flisboac/mixpower-path-nano-bq25620-board/kicad/projects/mixpower-path-nano-bq25620-board-r1/plot/mixpower-path-nano-bq25620-board-r1-output-headers.jpg

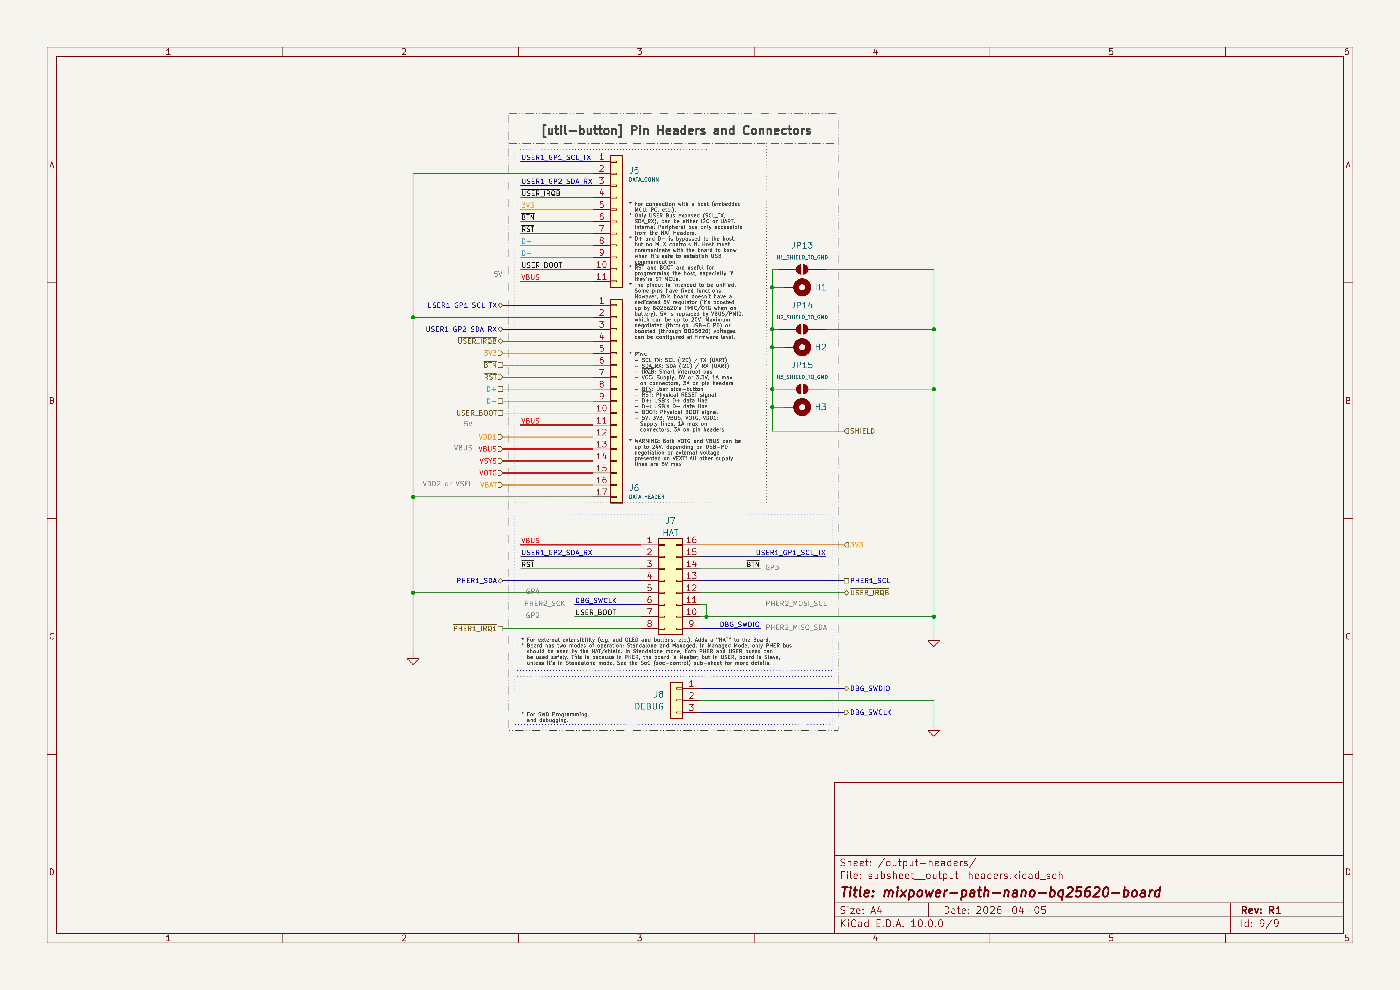
kicad/projects/mixpower-path-nano-bq25620-board-r1/plot/mixpower-path-nano-bq25620-board-r1-output-headers.jpg
