flisboac/mixpower-path-nano-bq25620-board/kicad/projects/mixpower-path-nano-bq25620-board-r1/plot/mixpower-path-nano-bq25620-board-r1.pdf

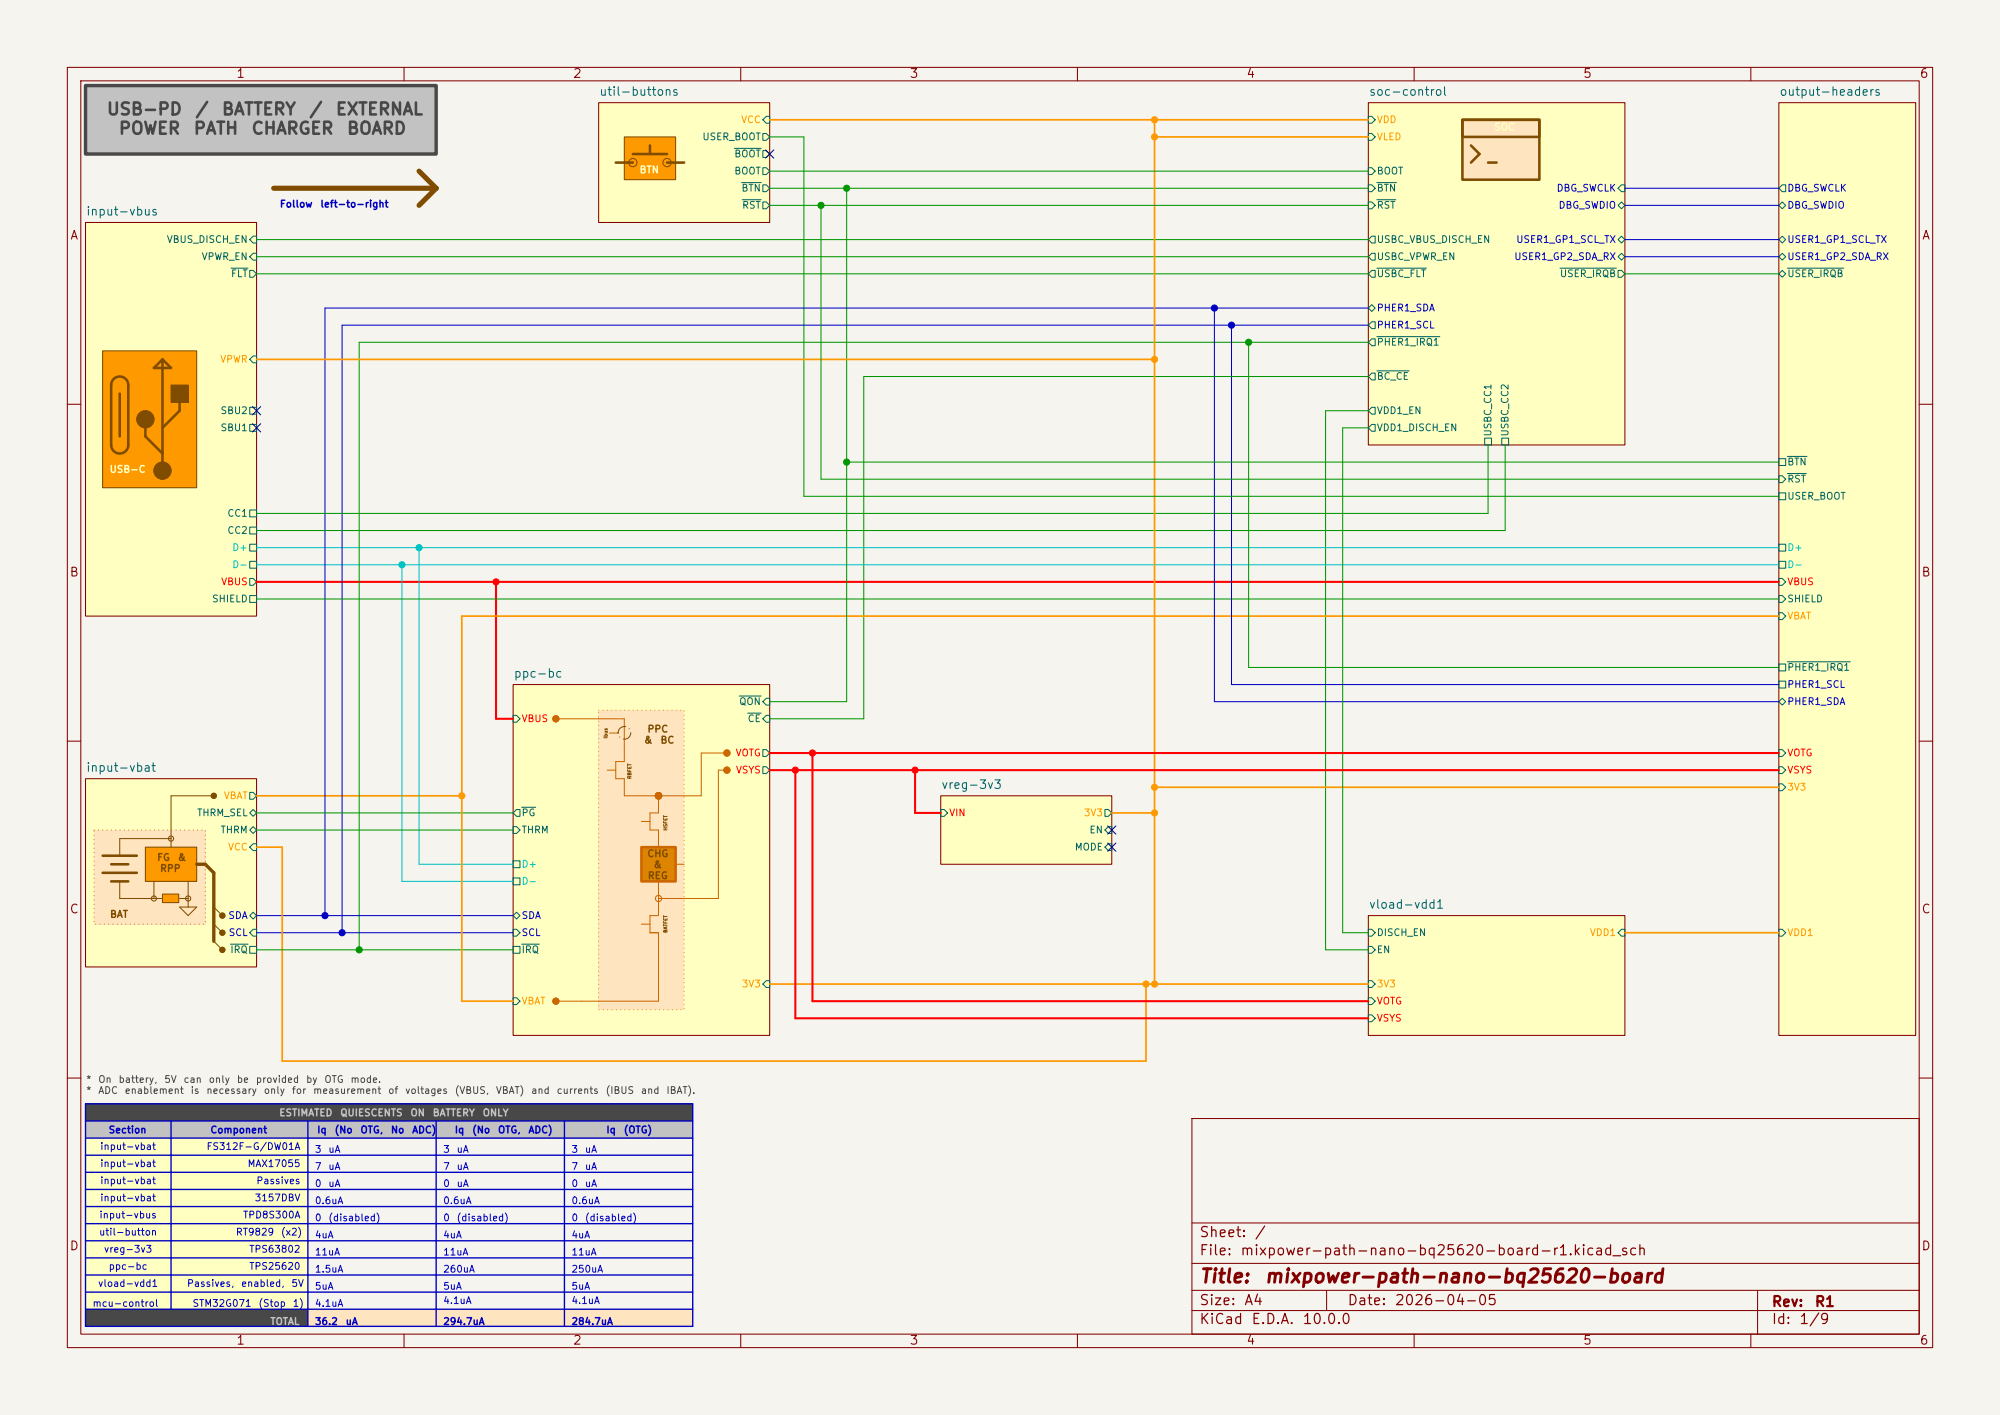
[picture p11: page 1]

* On battery, 5V can only be provided by OTG mode. * ADC enablement is necessary only for measurement of voltages (VBUS, VBAT) and currents (IBUS and IBAT). Ibus USB-PD / BATTERY / EXTERNAL
POWER PATH CHARGER BOARD

Follow left-to-right

input-vbat | FS312F-G/DW01A | 3 uA | 3 uA | 3 uA
input-vbat | MAX17055 | 7 uA | 7 uA | 7 uA
input-vbat | Passives | 0 uA | 0 uA | 0 uA
input-vbat | 3157DBV | 0.6uA | 0.6uA | 0.6uA
input-vbus | RT9829 (x2) TPD8S300A | 0 (disabled) 4uA | 0 (disabled) 4uA | 0 (disabled) util-button 4uA

Sheet: /
D Date: 2026-04-05 KiCad E.D.A. 10.0.0
File: mixpower-path-nano-bq25620-board-r1.kicad_sch
Title: mixpower-path-nano-bq25620-board

vreg-3v3 | TPS63802 TPS25620 | 11uA 1.5uA | 11uA 260uA | 11uA ppc-bc 250uA

vload-vdd1 | Passives, enabled, 5V STM32G071 (Stop 1) | 5uA 4.1uA | 5uA 4.1uA | 5uA mcu-control 4.1uA

Size: A4 | Rev: R1

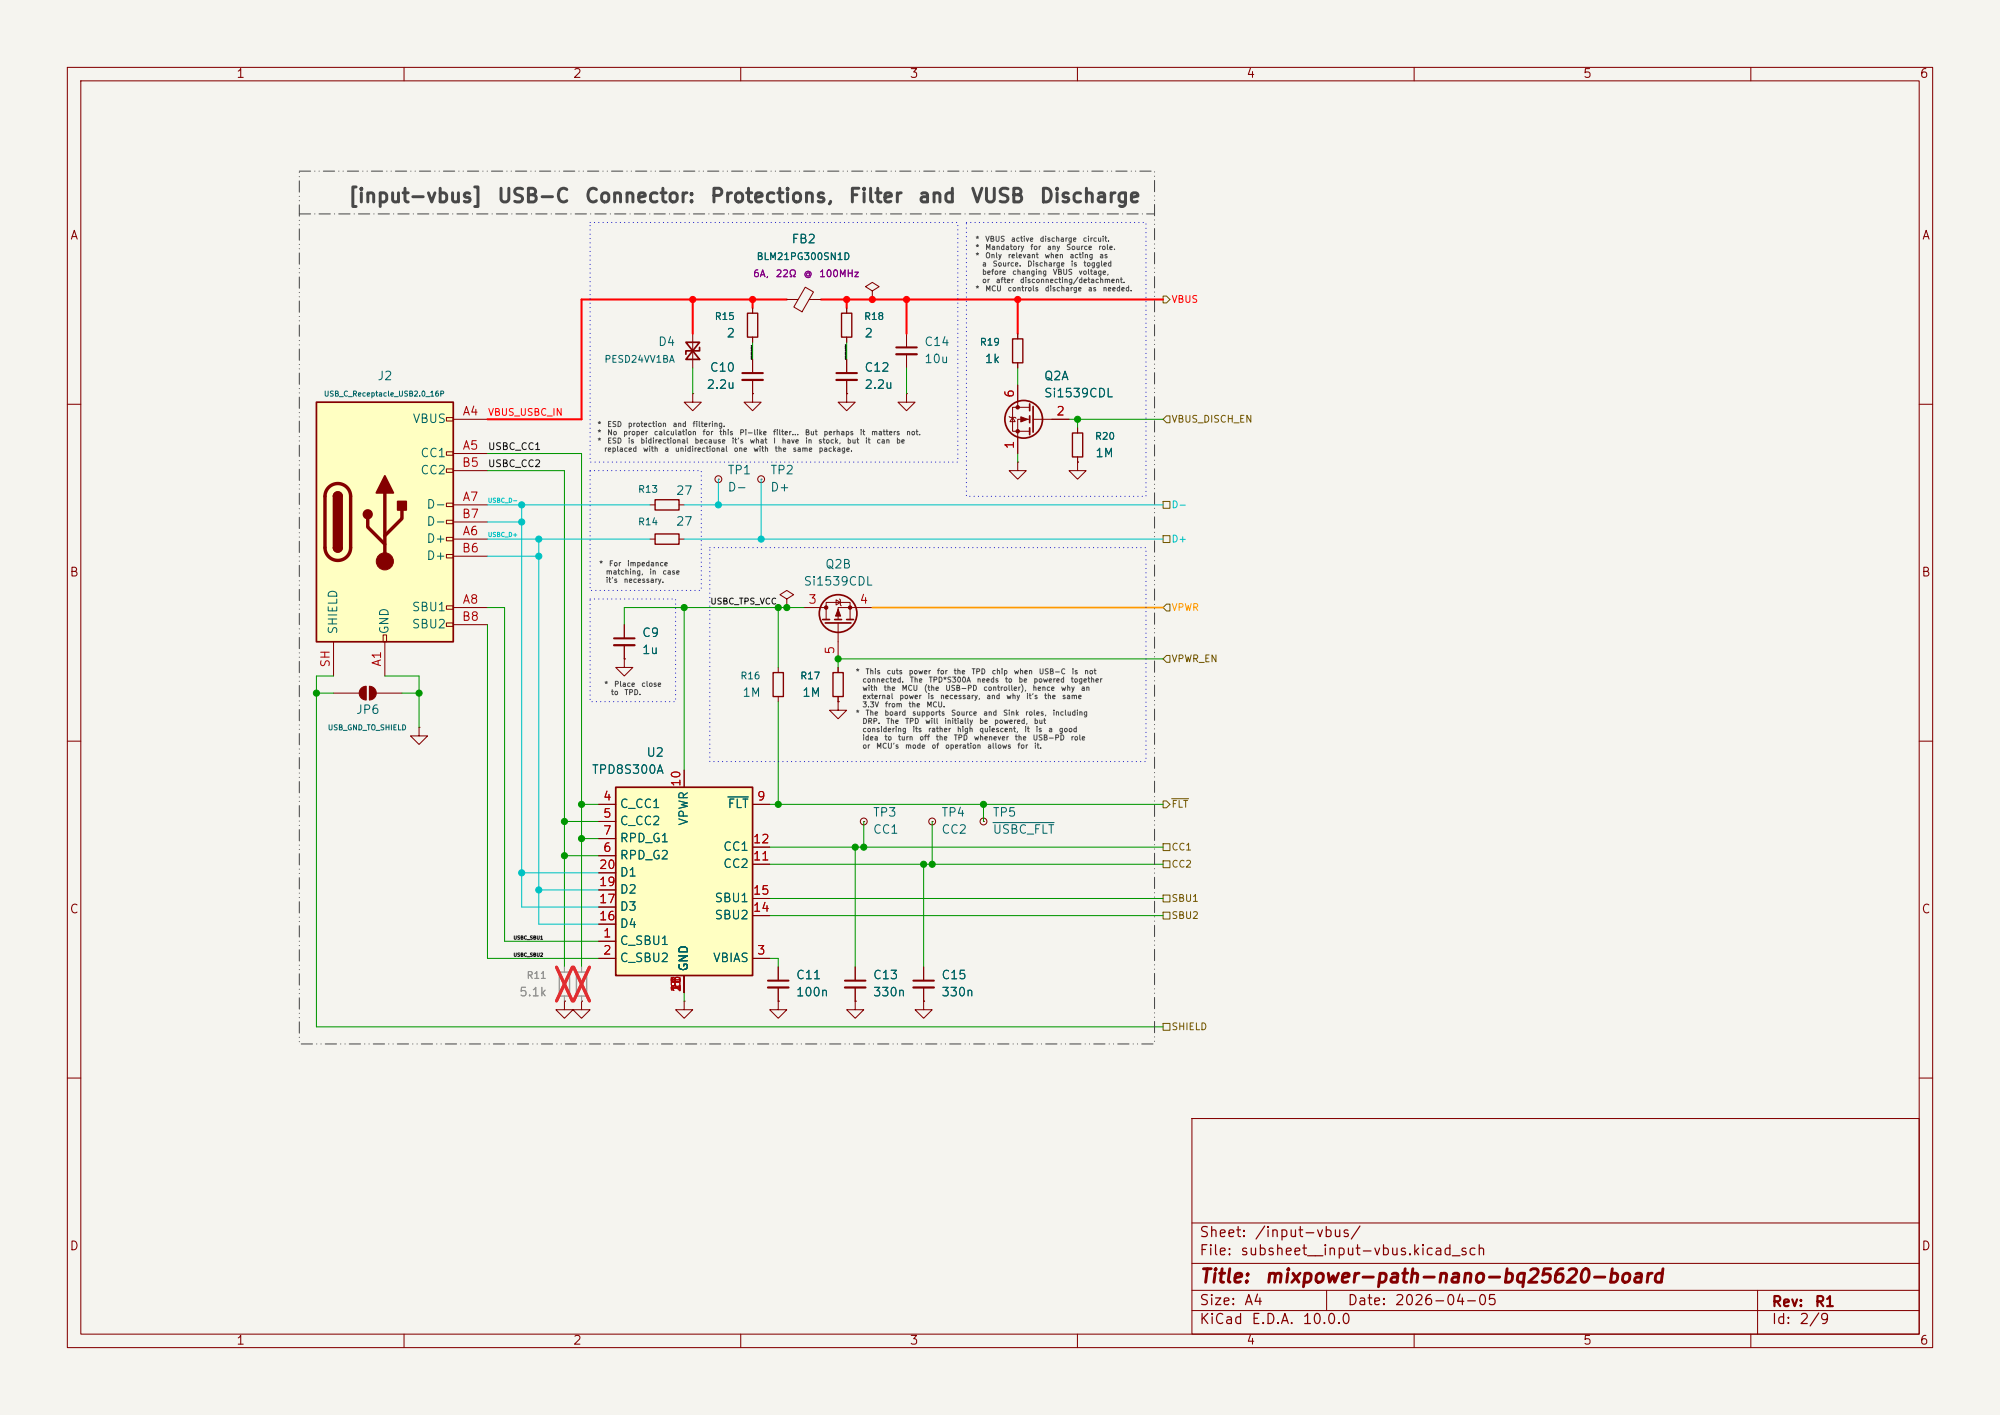
[picture p12: page 2]

before changing VBUS voltage, or after disconnecting/detachment. * MCU controls discharge as needed. [input-vbus] USB-C Connector: Protections, Filter and VUSB Discharge

replaced with a unidirectional one with the same package. FB2

* VBUS active discharge circuit. * Mandatory for any Source role. * Only relevant when acting as a Source. Discharge is toggled

to TPD. * ESD protection and filtering. * No proper calculation for this Pi-like filter... But perhaps it matters not. * ESD is bidirectional because it's what I have in stock, but it can be

external power is necessary, and why it's the same 3.3V from the MCU. * The board supports Source and Sink roles, including DRP. The TPD will initially be powered, but considering its rather high quiescent, it is a good

idea to turn off the TPD whenever the USB-PD role or MCU's mode of operation allows for it.

Sheet: /input-vbus/
D Date: 2026-04-05 KiCad E.D.A. 10.0.0
File: subsheet__input-vbus.kicad_sch
Title: mixpower-path-nano-bq25620-board

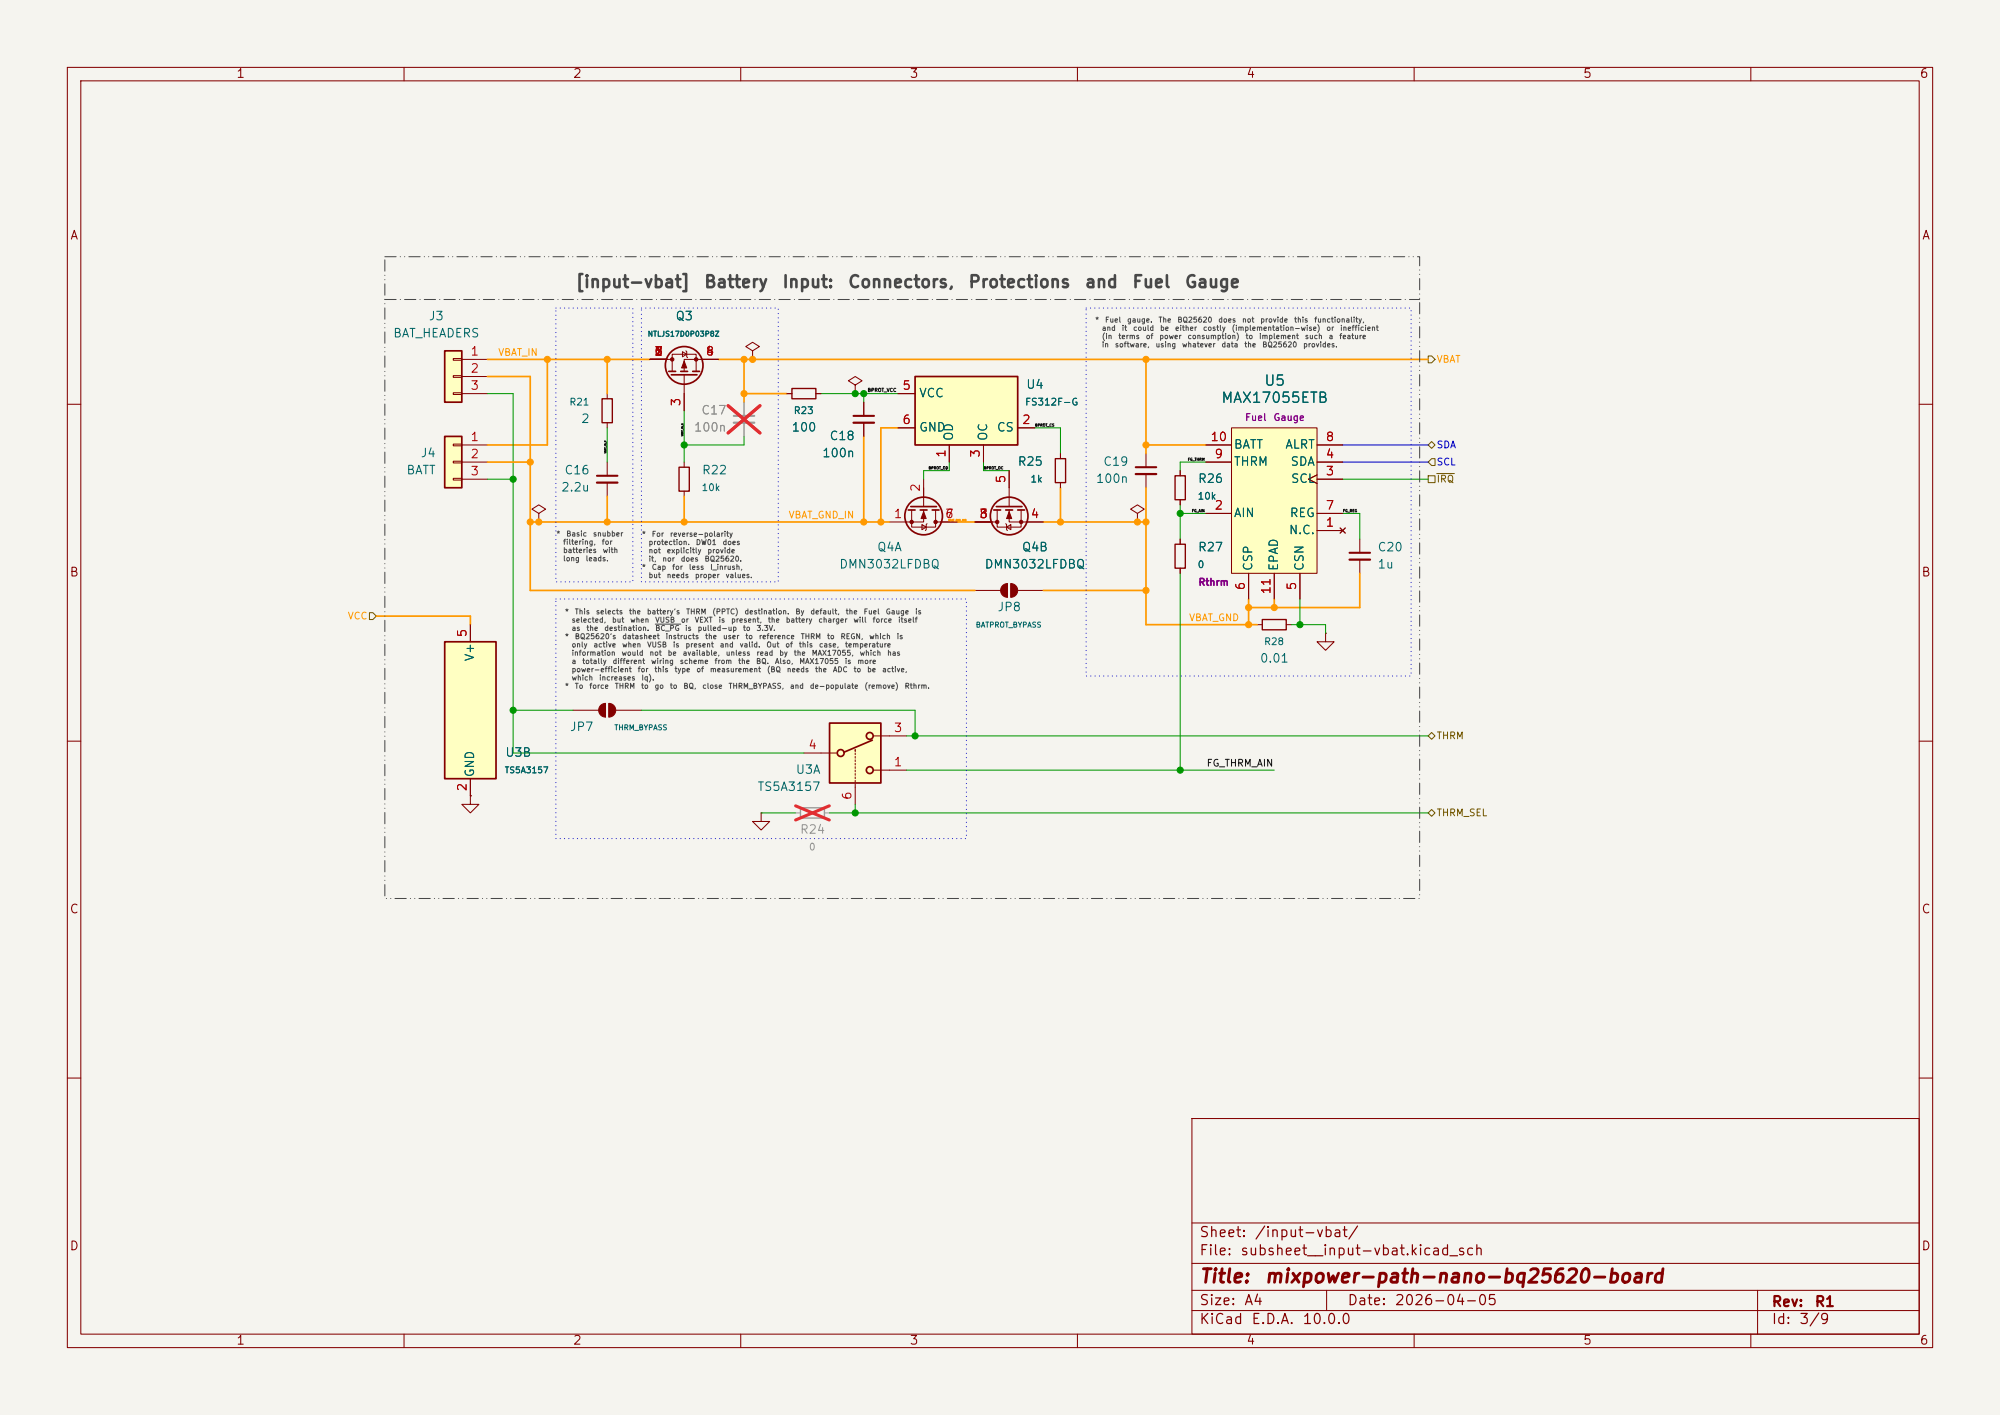
[picture p13: page 3]

in software, using whatever data the BQ25620 provides. U4

information would not be available, unless read by the MAX17055, which has a totally different wiring scheme from the BQ. Also, MAX17055 is more power-efficient for this type of measurement (BQ needs the ADC to be active, which increases Iq). * To force THRM to go to BQ, close THRM_BYPASS, and de-populate (remove) Rthrm. * Basic snubber
filtering, for batteries with

* For reverse-polarity protection. DW01 does not explicitly provide

it, nor does BQ25620. * Cap for less I_inrush, but needs proper values. * This selects the battery's THRM (PPTC) destination. By default, the Fuel Gauge is

selected, but when VUSB or VEXT is present, the battery charger will force itself as the destination. BC_PG is pulled-up to 3.3V. * BQ25620's datasheet instructs the user to reference THRM to REGN, which is only active when VUSB is present and valid. Out of this case, temperature

Sheet: /input-vbat/
D Date: 2026-04-05 KiCad E.D.A. 10.0.0
File: subsheet__input-vbat.kicad_sch
Title: mixpower-path-nano-bq25620-board

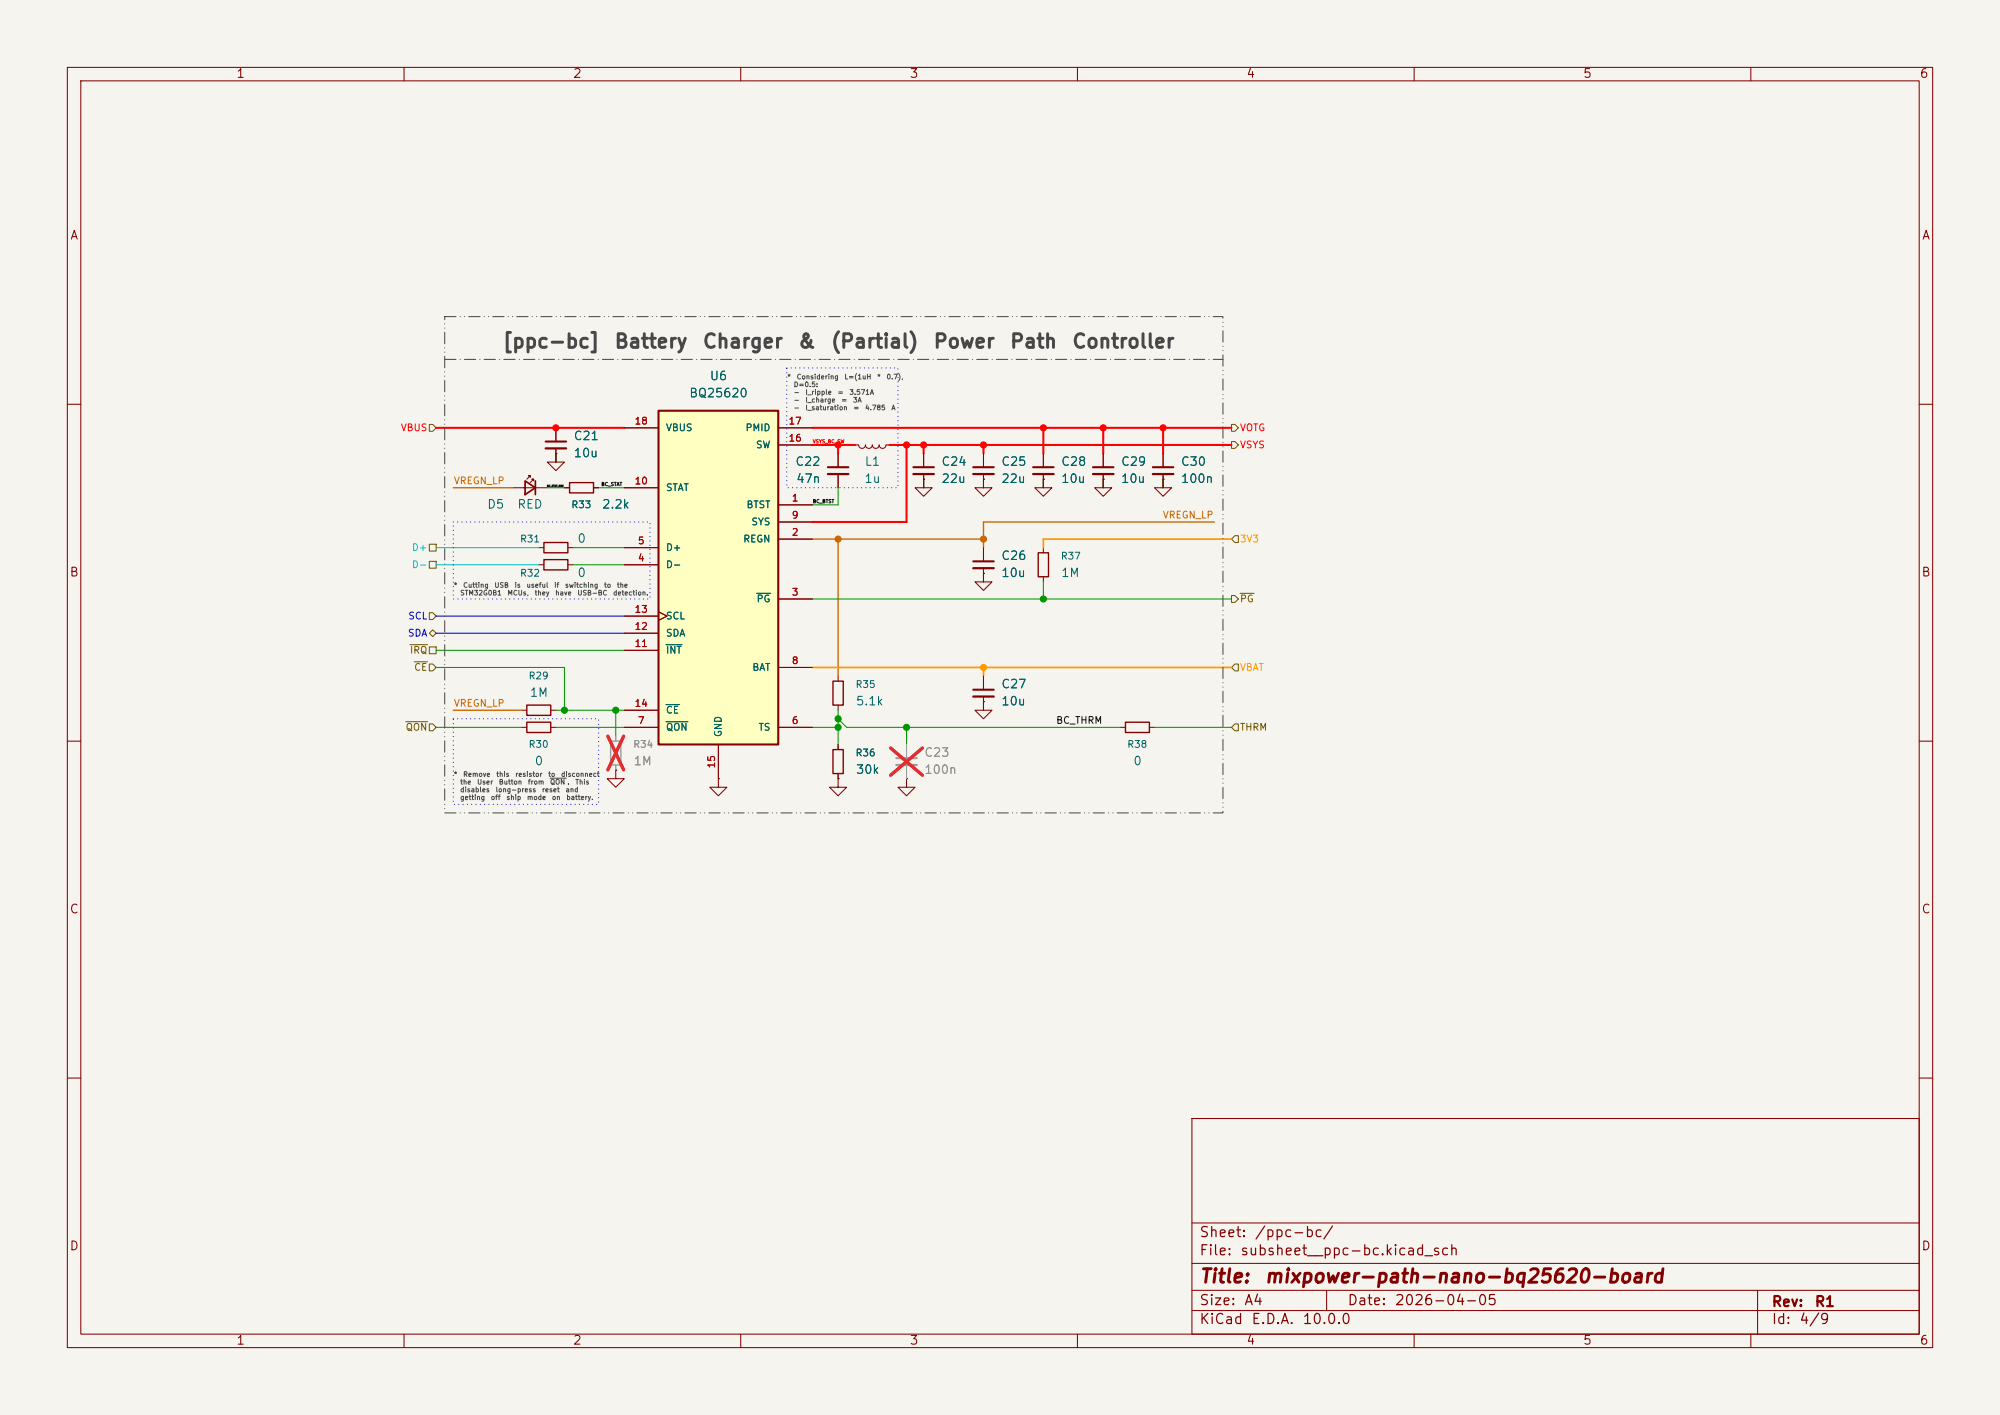
[picture p14: page 4]

VSYS_BC_SW [ppc-bc] Battery Charger & (Partial) Power Path Controller

* Remove this resistor to disconnect
the User Button from QON . This disables long-press reset and

Sheet: /ppc-bc/
D Date: 2026-04-05 KiCad E.D.A. 10.0.0
File: subsheet__ppc-bc.kicad_sch
Title: mixpower-path-nano-bq25620-board

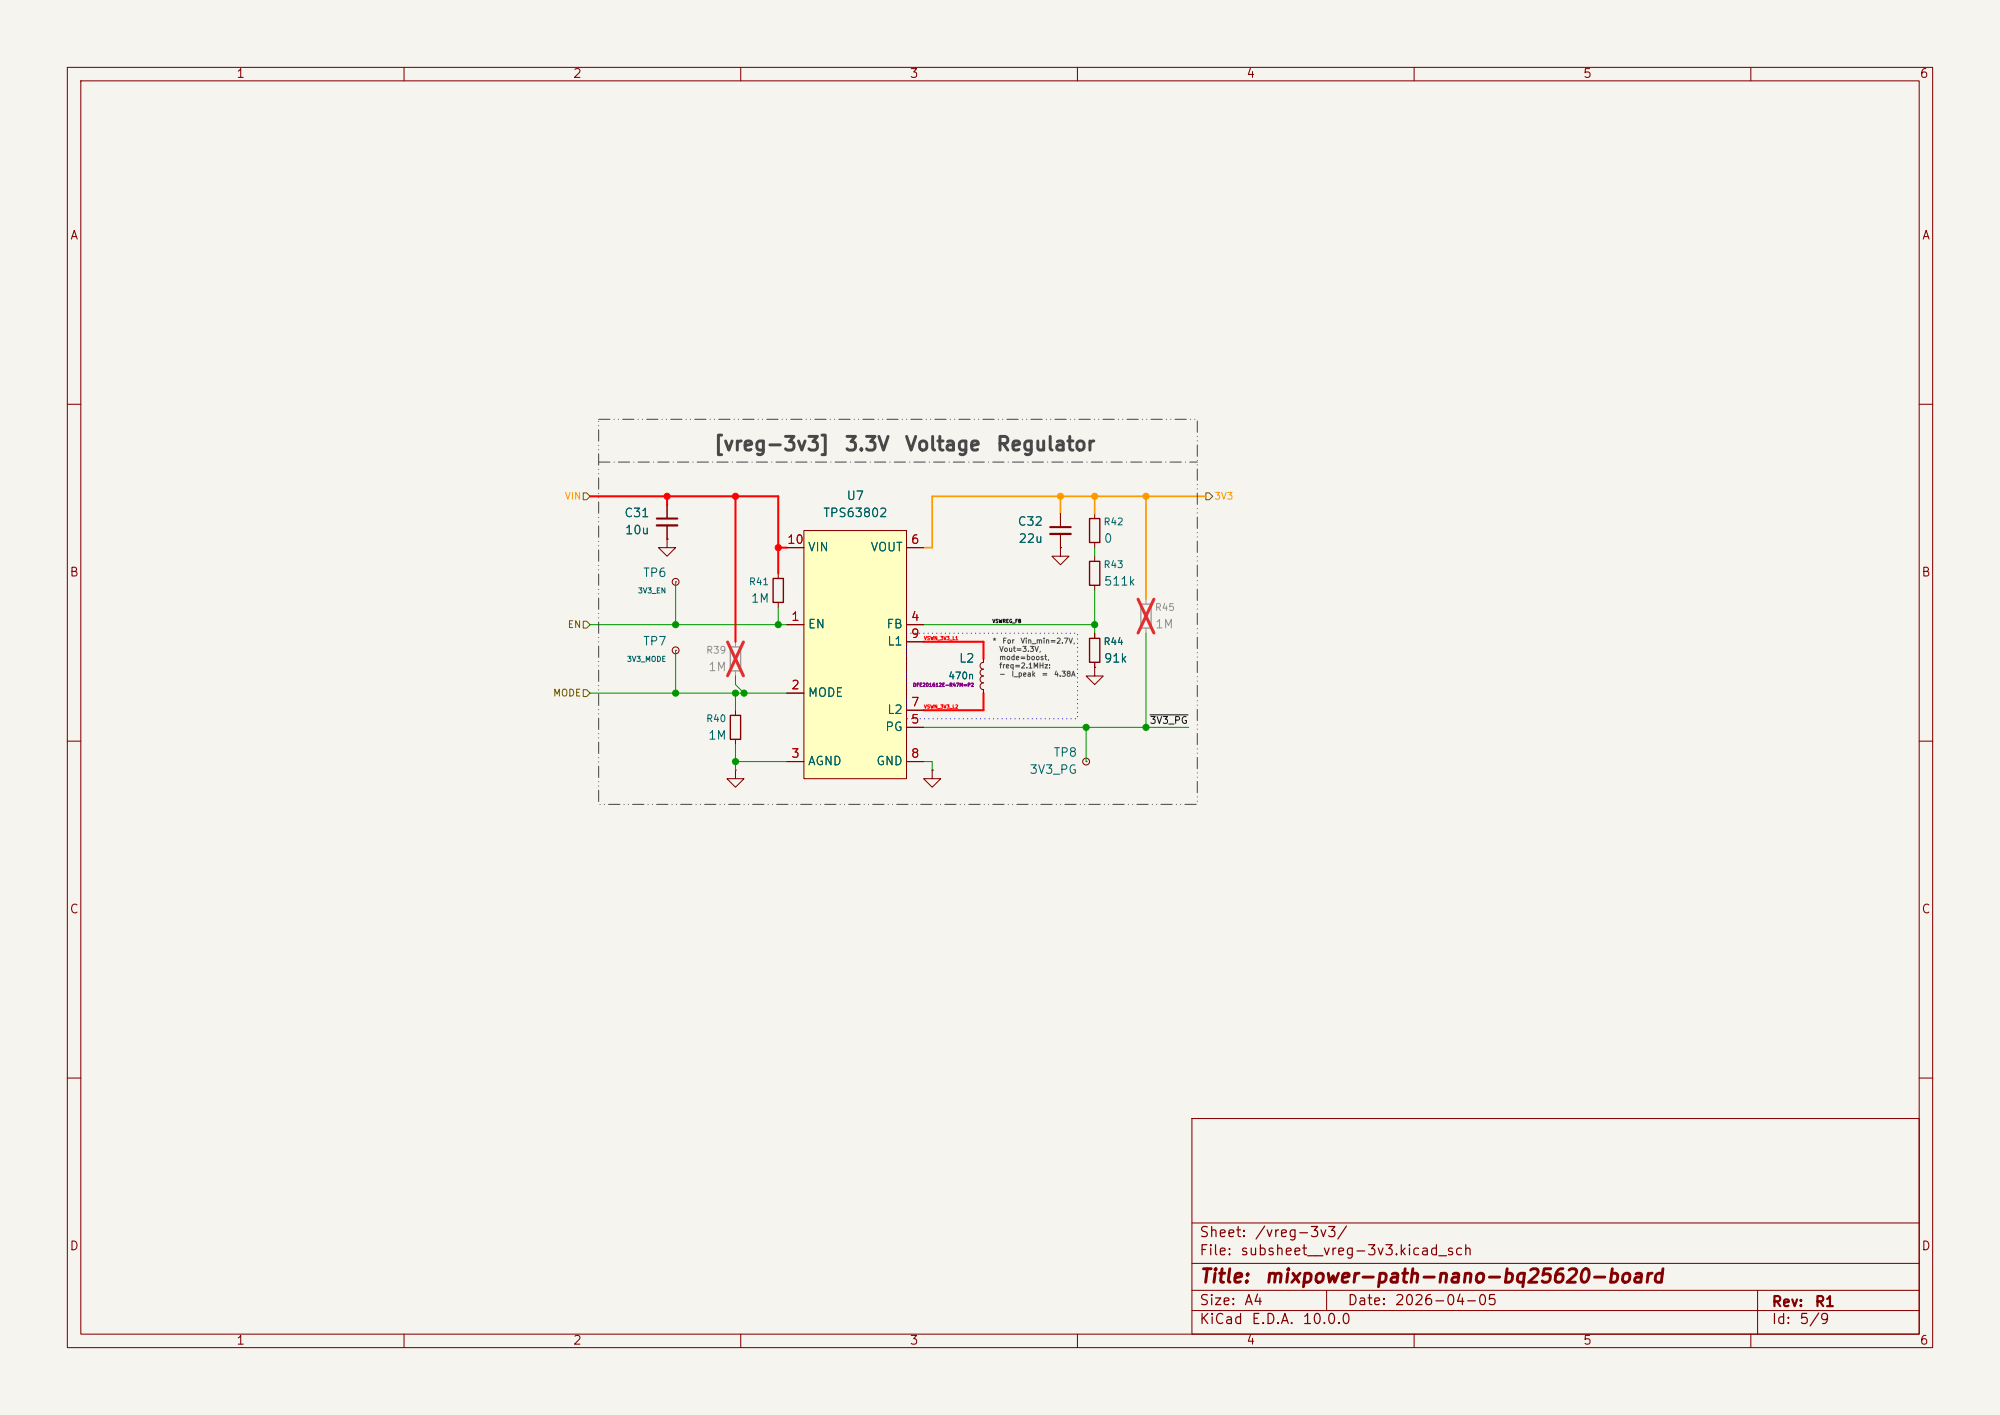
[picture p15: page 5]

* For Vin_min=2.7V, Vout=3.3V, mode=boost, freq=2.1MHz: - I_peak = 4.38A [vreg-3v3] 3.3V Voltage Regulator U7

Sheet: /vreg-3v3/
D Date: 2026-04-05 KiCad E.D.A. 10.0.0
File: subsheet__vreg-3v3.kicad_sch
Title: mixpower-path-nano-bq25620-board

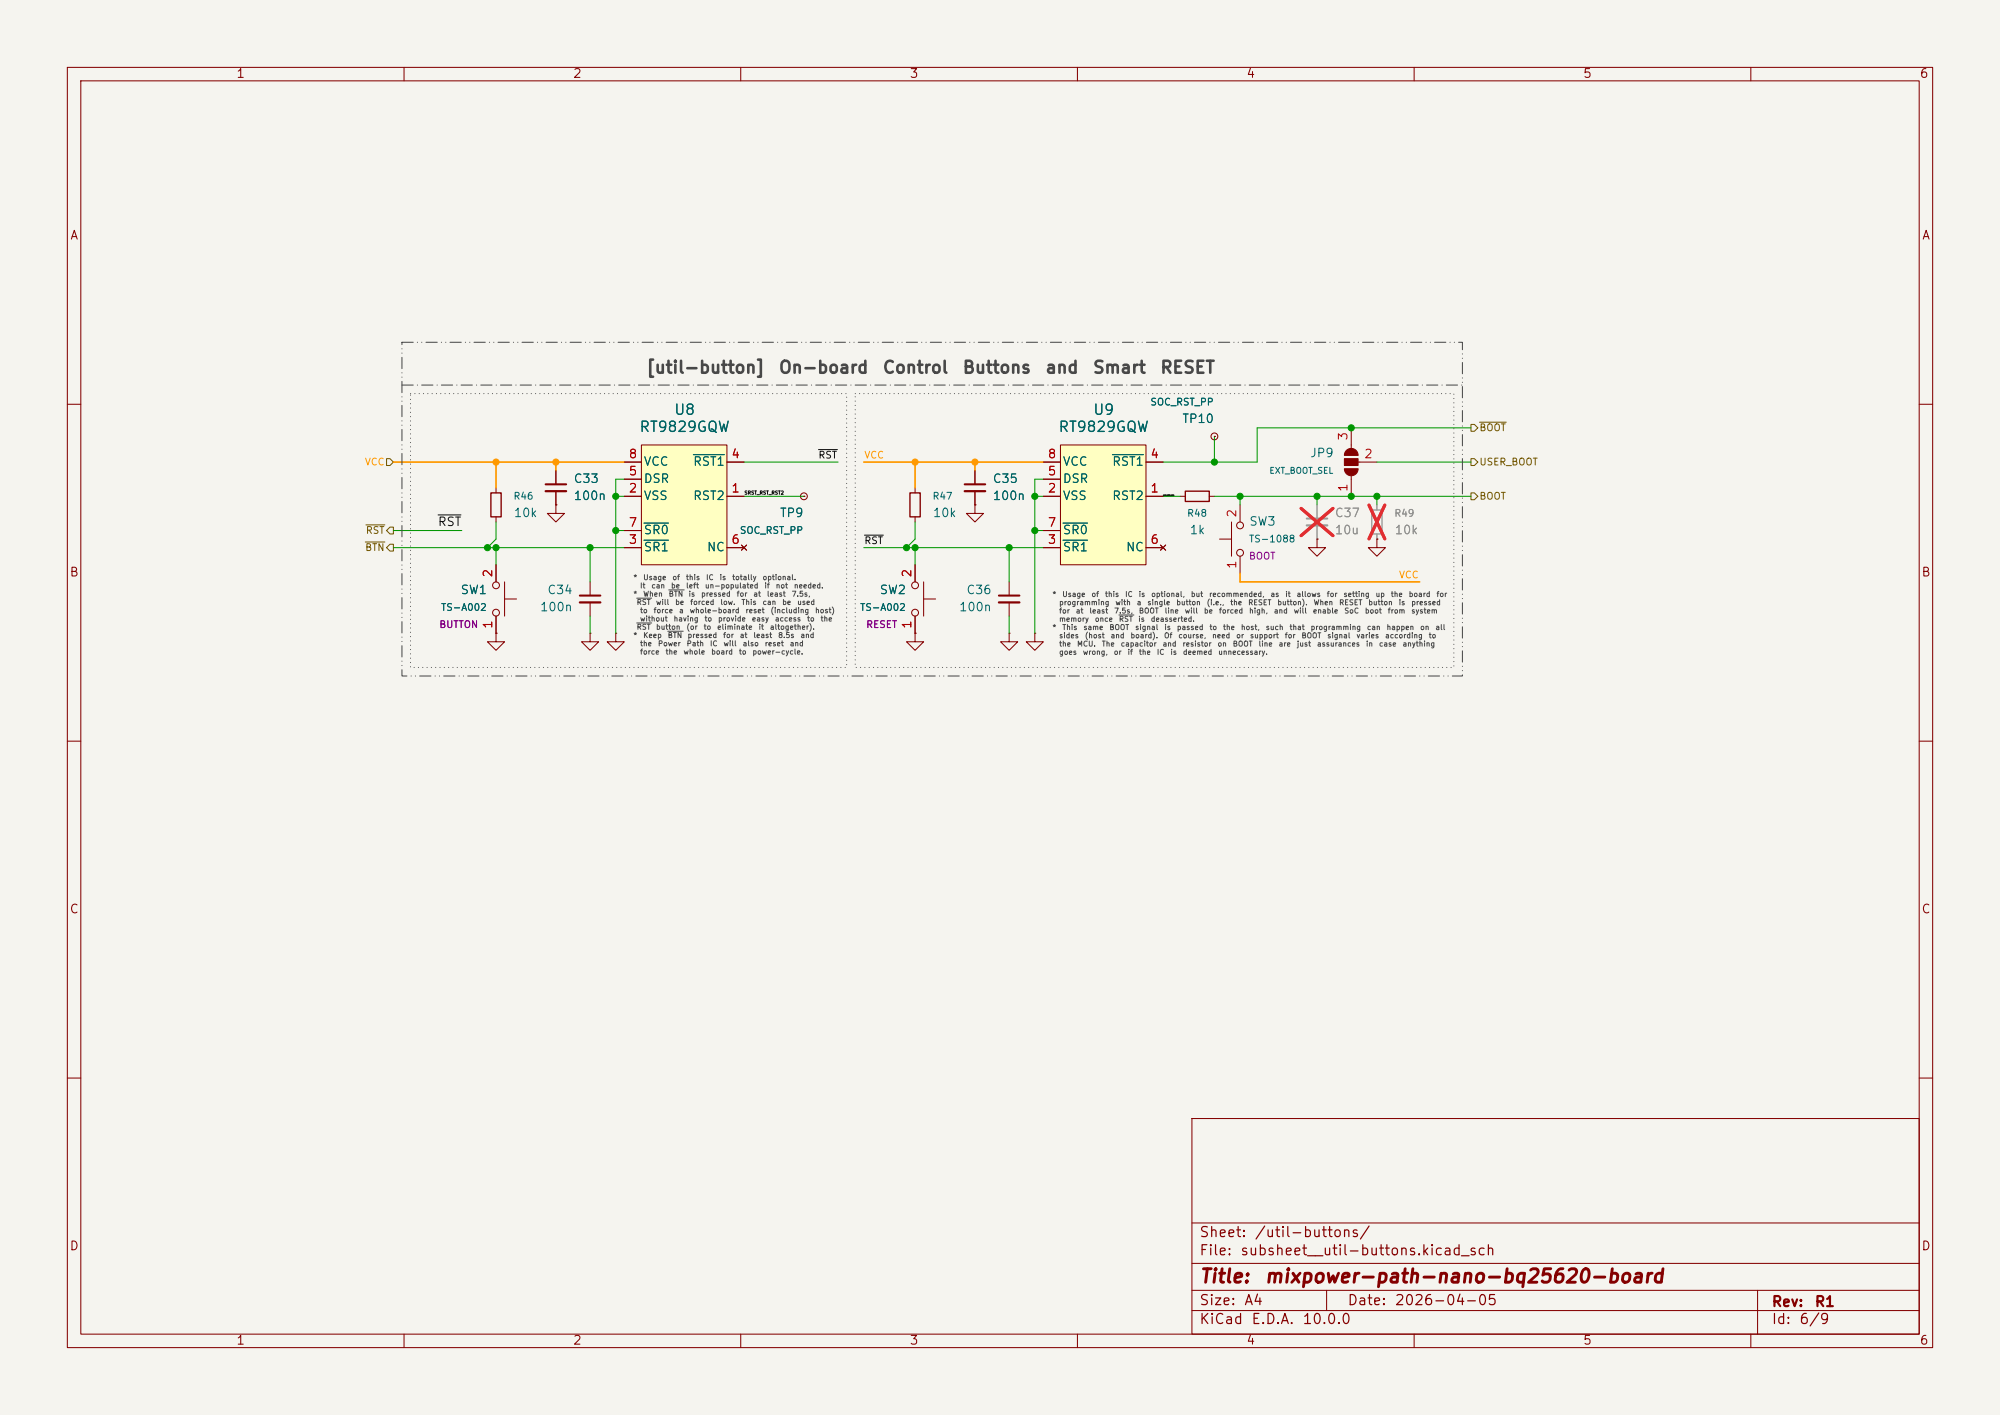
[picture p16: page 6]

force the whole board to power-cycle. [util-button] On-board Control Buttons and Smart RESET

* Usage of this IC is totally optional.
It can be left un-populated if not needed. * When BTN is pressed for at least 7.5s, RST will be forced low. This can be used

goes wrong, or if the IC is deemed unnecessary. SW1

* Usage of this IC is optional, but recommended, as it allows for setting up the board for programming with a single button (i.e., the RESET button). When RESET button is pressed

to force a whole-board reset (including host) without having to provide easy access to the RST button (or to eliminate it altogether). * Keep BTN pressed for at least 8.5s and

for at least 7.5s, BOOT line will be forced high, and will enable SoC boot from system
memory once RST is deasserted. * This same BOOT signal is passed to the host, such that programming can happen on all sides (host and board). Of course, need or support for BOOT signal varies according to

the Power Path IC will also reset and

the MCU. The capacitor and resistor on BOOT line are just assurances in case anything

Sheet: /util-buttons/
D Date: 2026-04-05 KiCad E.D.A. 10.0.0
File: subsheet__util-buttons.kicad_sch
Title: mixpower-path-nano-bq25620-board

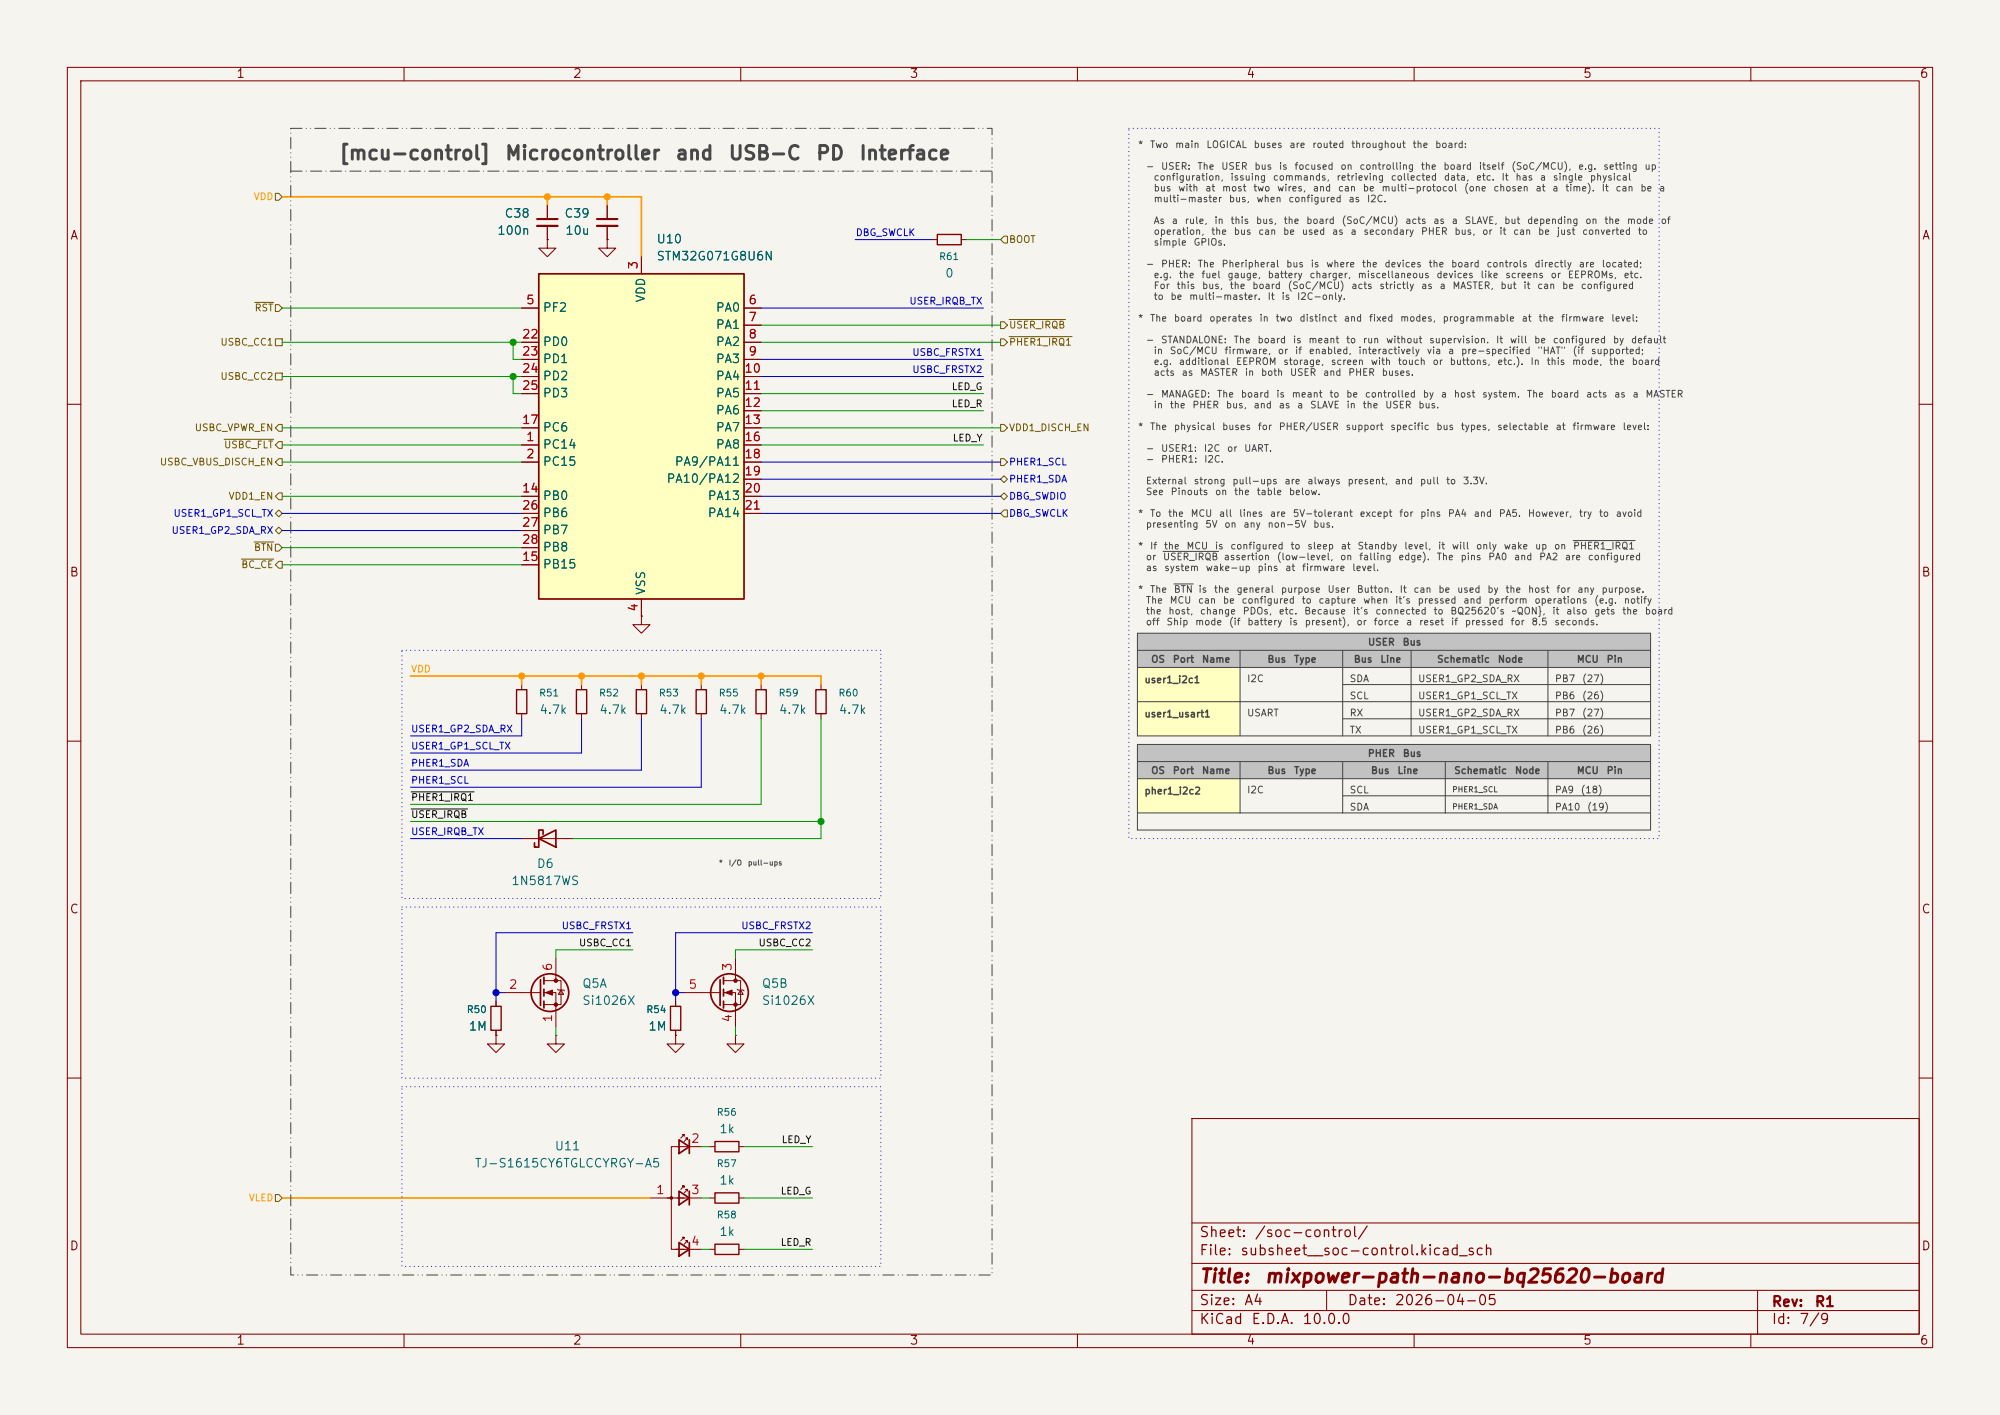
[picture p17: page 7]

* Two main LOGICAL buses are routed throughout the board: - USER: The USER bus is focused on controlling the board itself (SoC/MCU), e.g. setting up
BOOT PHER1_SCL DBG_SWDIO
PHER1_IRQ1 DBG_SWCLK

[mcu-control] Microcontroller and USB-C PD Interface
RST VDD USBC_CC1 USBC_CC2 USER1_GP1_SCL_TX USBC_VPWR_EN

simple GPIOs. - PHER: The Pheripheral bus is where the devices the board controls directly are located; e.g. the fuel gauge, battery charger, miscellaneous devices like screens or EEPROMs, etc. For this bus, the board (SoC/MCU) acts strictly as a MASTER, but it can be configured

to be multi-master. It is I2C-only. * The board operates in two distinct and fixed modes, programmable at the firmware level: - STANDALONE: The board is meant to run without supervision. It will be configured by default

in SoC/MCU firmware, or if enabled, interactively via a pre-specified "HAT" (if supported; e.g. additional EEPROM storage, screen with touch or buttons, etc.). In this mode, the board

acts as MASTER in both USER and PHER buses. - MANAGED: The board is meant to be controlled by a host system. The board acts as a MASTER

in the PHER bus, and as a SLAVE in the USER bus. * The physical buses for PHER/USER support specific bus types, selectable at firmware level: - USER1: I2C or UART. - PHER1: I2C. External strong pull-ups are always present, and pull to 3.3V. See Pinouts on the table below. * To the MCU all lines are 5V-tolerant except for pins PA4 and PA5. However, try to avoid

presenting 5V on any non-5V bus. * If the MCU is configured to sleep at Standby level, it will only wake up on PHER1_IRQ1

or USER_IRQB assertion (low-level, on falling edge). The pins PA0 and PA2 are configured
as system wake-up pins at firmware level. * The BTN is the general purpose User Button. It can be used by the host for any purpose. The MCU can be configured to capture when it's pressed and perform operations (e.g. notify

off Ship mode (if battery is present), or force a reset if pressed for 8.5 seconds. * I/O pull-ups

the host, change PDOs, etc. Because it's connected to BQ25620's ~QON}, it also gets the board

Sheet: /soc-control/
D Date: 2026-04-05 KiCad E.D.A. 10.0.0
File: subsheet__soc-control.kicad_sch
Title: mixpower-path-nano-bq25620-board

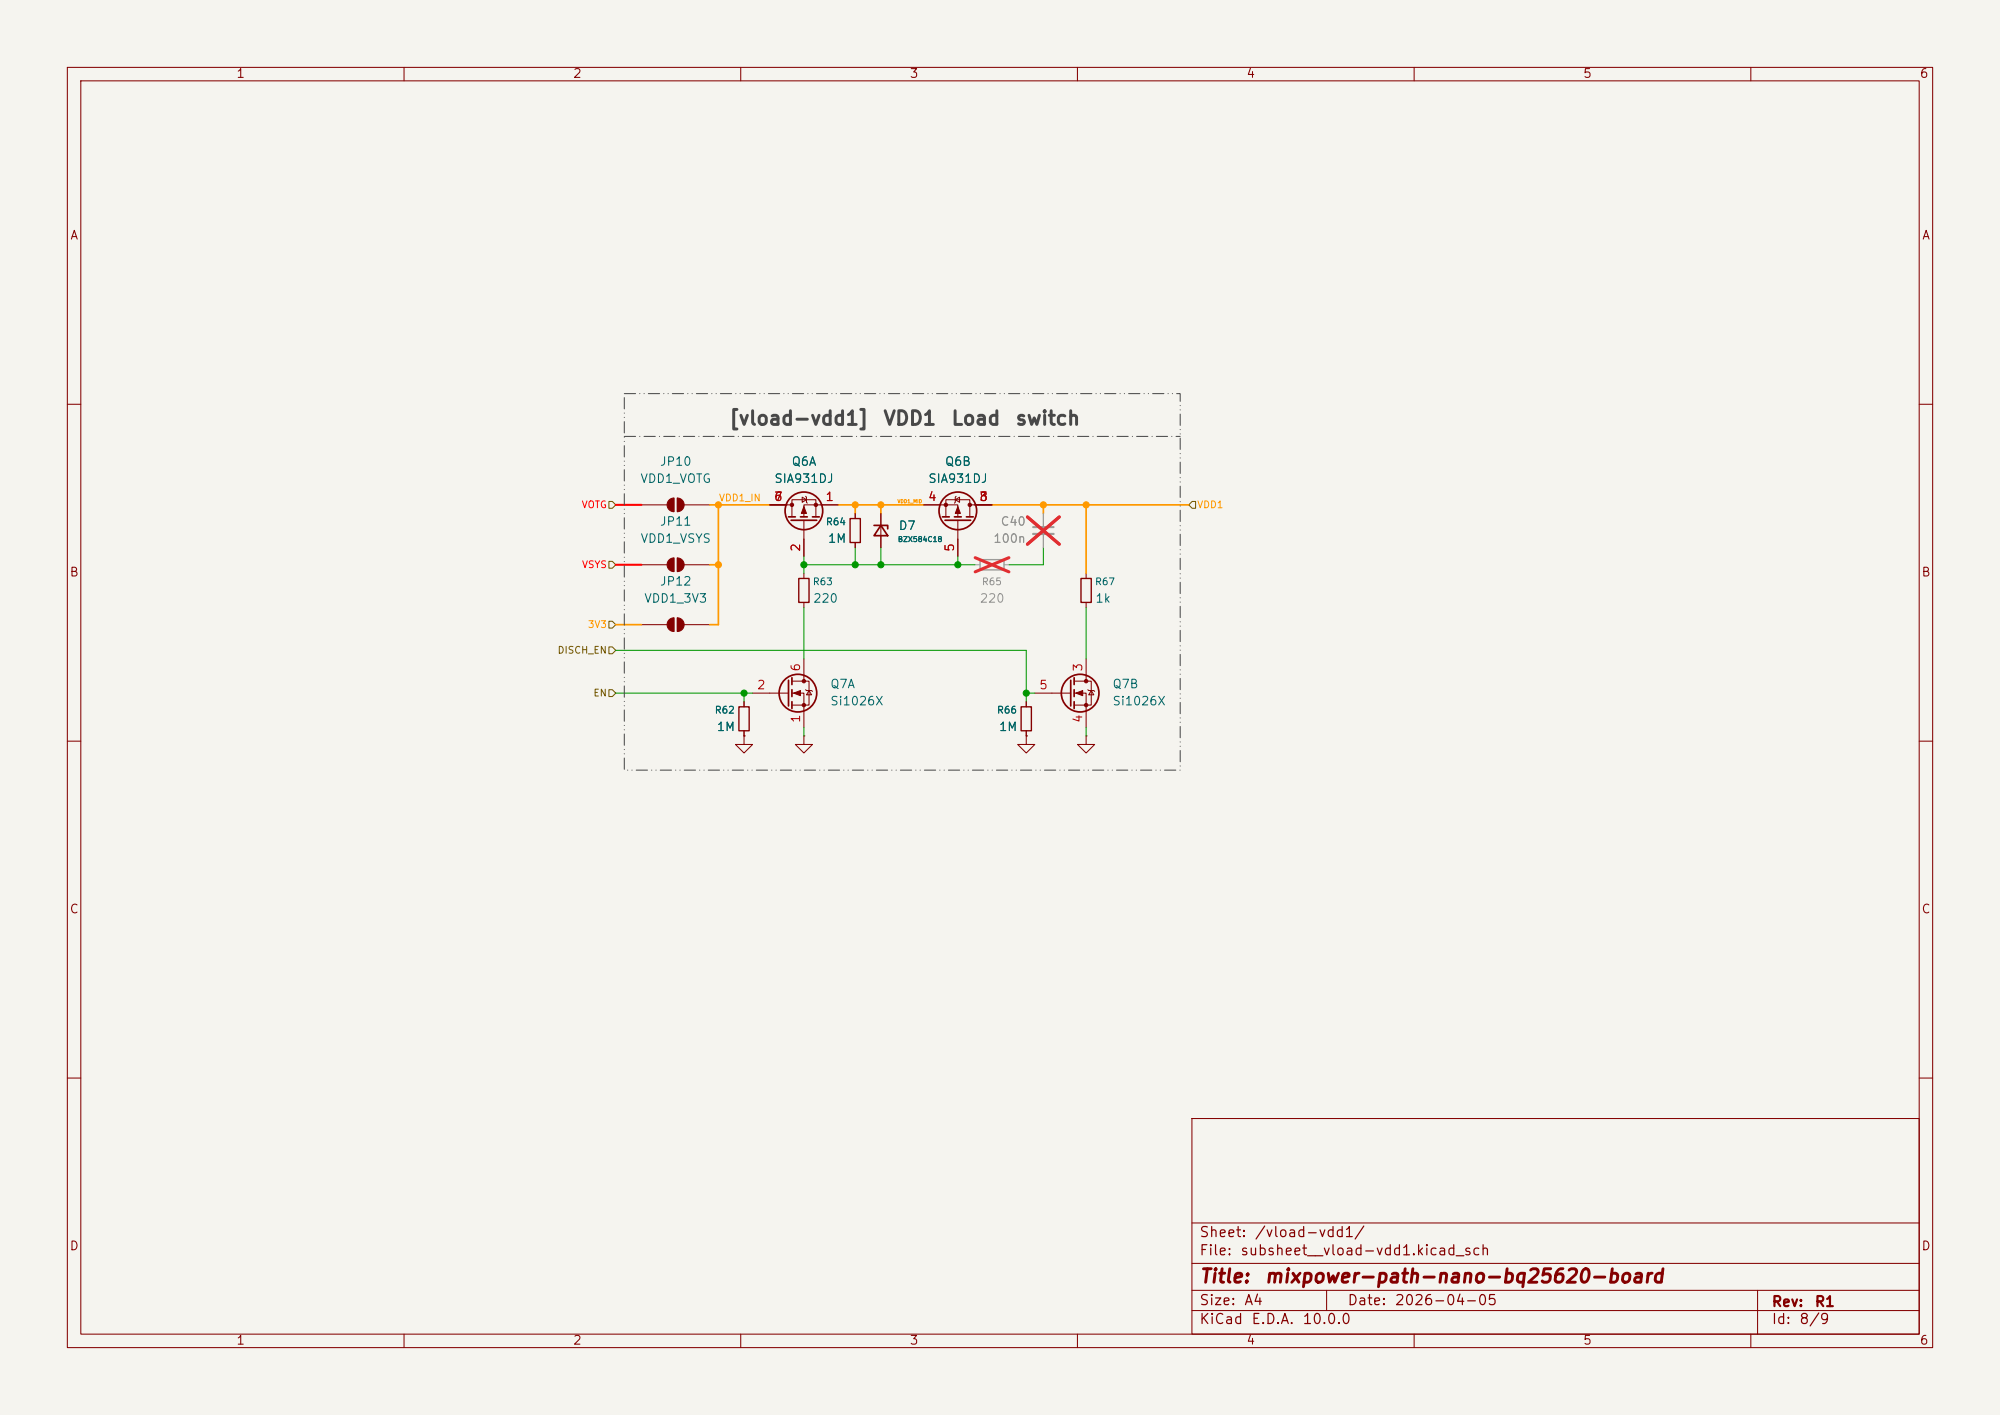
[picture p18: page 8]

Sheet: /vload-vdd1/
D Date: 2026-04-05 KiCad E.D.A. 10.0.0
File: subsheet__vload-vdd1.kicad_sch
Title: mixpower-path-nano-bq25620-board

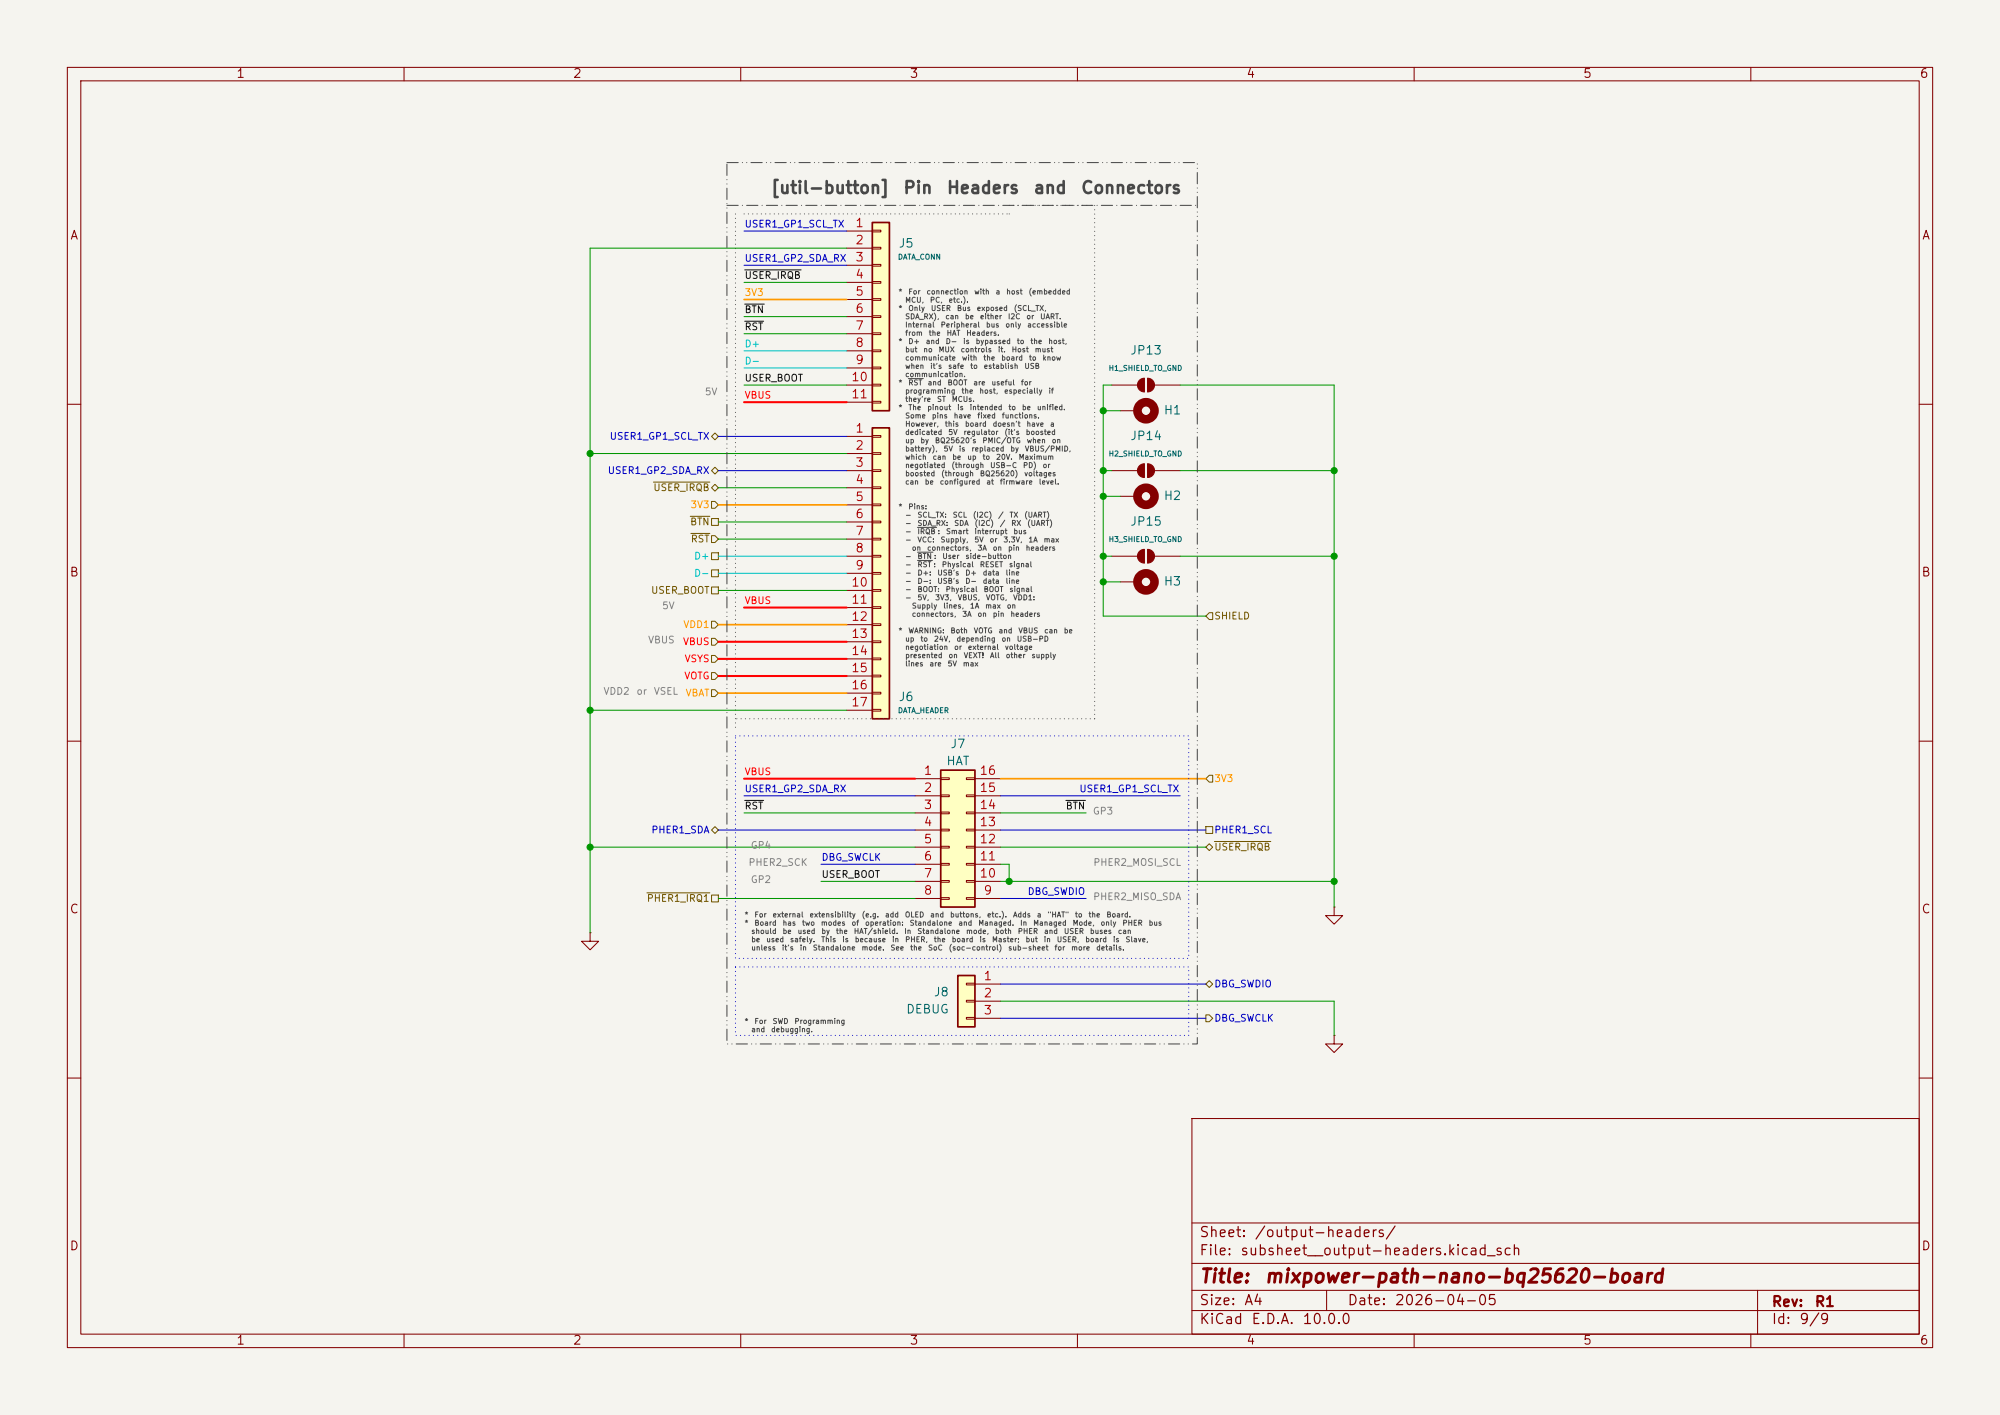
[picture p19: page 9]

lines are 5V max [util-button] Pin Headers and Connectors
USER1_GP1_SCL_TX RST
VBUS USER_IRQB USER_BOOT USER1_GP2_SDA_RX
VBUS RST 3V3
BTN

* For connection with a host (embedded MCU, PC, etc.). * Only USER Bus exposed (SCL_TX, SDA_RX), can be either I2C or UART.

Internal Peripheral bus only accessible
from the HAT Headers. * D+ and D- is bypassed to the host, but no MUX controls it. Host must communicate with the board to know

when it's safe to establish USB
communication. * RST and BOOT are useful for programming the host, especially if

VBUS RST USER1_GP2_SDA_RX BTN USER_IRQB VBAT 3V3 D+ VDD1 USER_BOOT VOTG 5V VBUS | VBUS PHER2_SCK 10 11

they're ST MCUs. * The pinout is intended to be unified. Some pins have fixed functions. However, this board doesn't have a

dedicated 5V regulator (it's boosted
up by BQ25620's PMIC/OTG when on
battery), 5V is replaced by VBUS/PMID, which can be up to 20V. Maximum

negotiated (through USB-C PD) or boosted (through BQ25620) voltages can be configured at firmware level. * Pins: - SCL_TX: SCL (I2C) / TX (UART) - SDA_RX: SDA (I2C) / RX (UART) - IRQB : Smart interrupt bus - VCC: Supply, 5V or 3.3V, 1A max on connectors, 3A on pin headers - BTN : User side-button - RST : Physical RESET signal - D+: USB's D+ data line - D-: USB's D- data line - BOOT: Physical BOOT signal - 5V, 3V3, VBUS, VOTG, VDD1: Supply lines, 1A max on

connectors, 3A on pin headers

* WARNING: Both VOTG and VBUS can be up to 24V, depending on USB-PD

negotiation or external voltage presented on VEXT! All other supply

* For external extensibility (e.g. add OLED and buttons, etc.). Adds a "HAT" to the Board. * Board has two modes of operation: Standalone and Managed. In Managed Mode, only PHER bus

should be used by the HAT/shield. In Standalone mode, both PHER and USER buses can
be used safely. This is because in PHER, the board is Master; but in USER, board is Slave, unless it's in Standalone mode. See the SoC (soc-control) sub-sheet for more details. * For SWD Programming

File: subsheet__output-headers.kicad_sch
Title: mixpower-path-nano-bq25620-board
