flisboac/mixpower-path-nano-bq25620-board/kicad/projects/mixpower-path-mini-axp2585-board-r1/plot/mixpower-path-mini-axp2585-board-r1.pdf

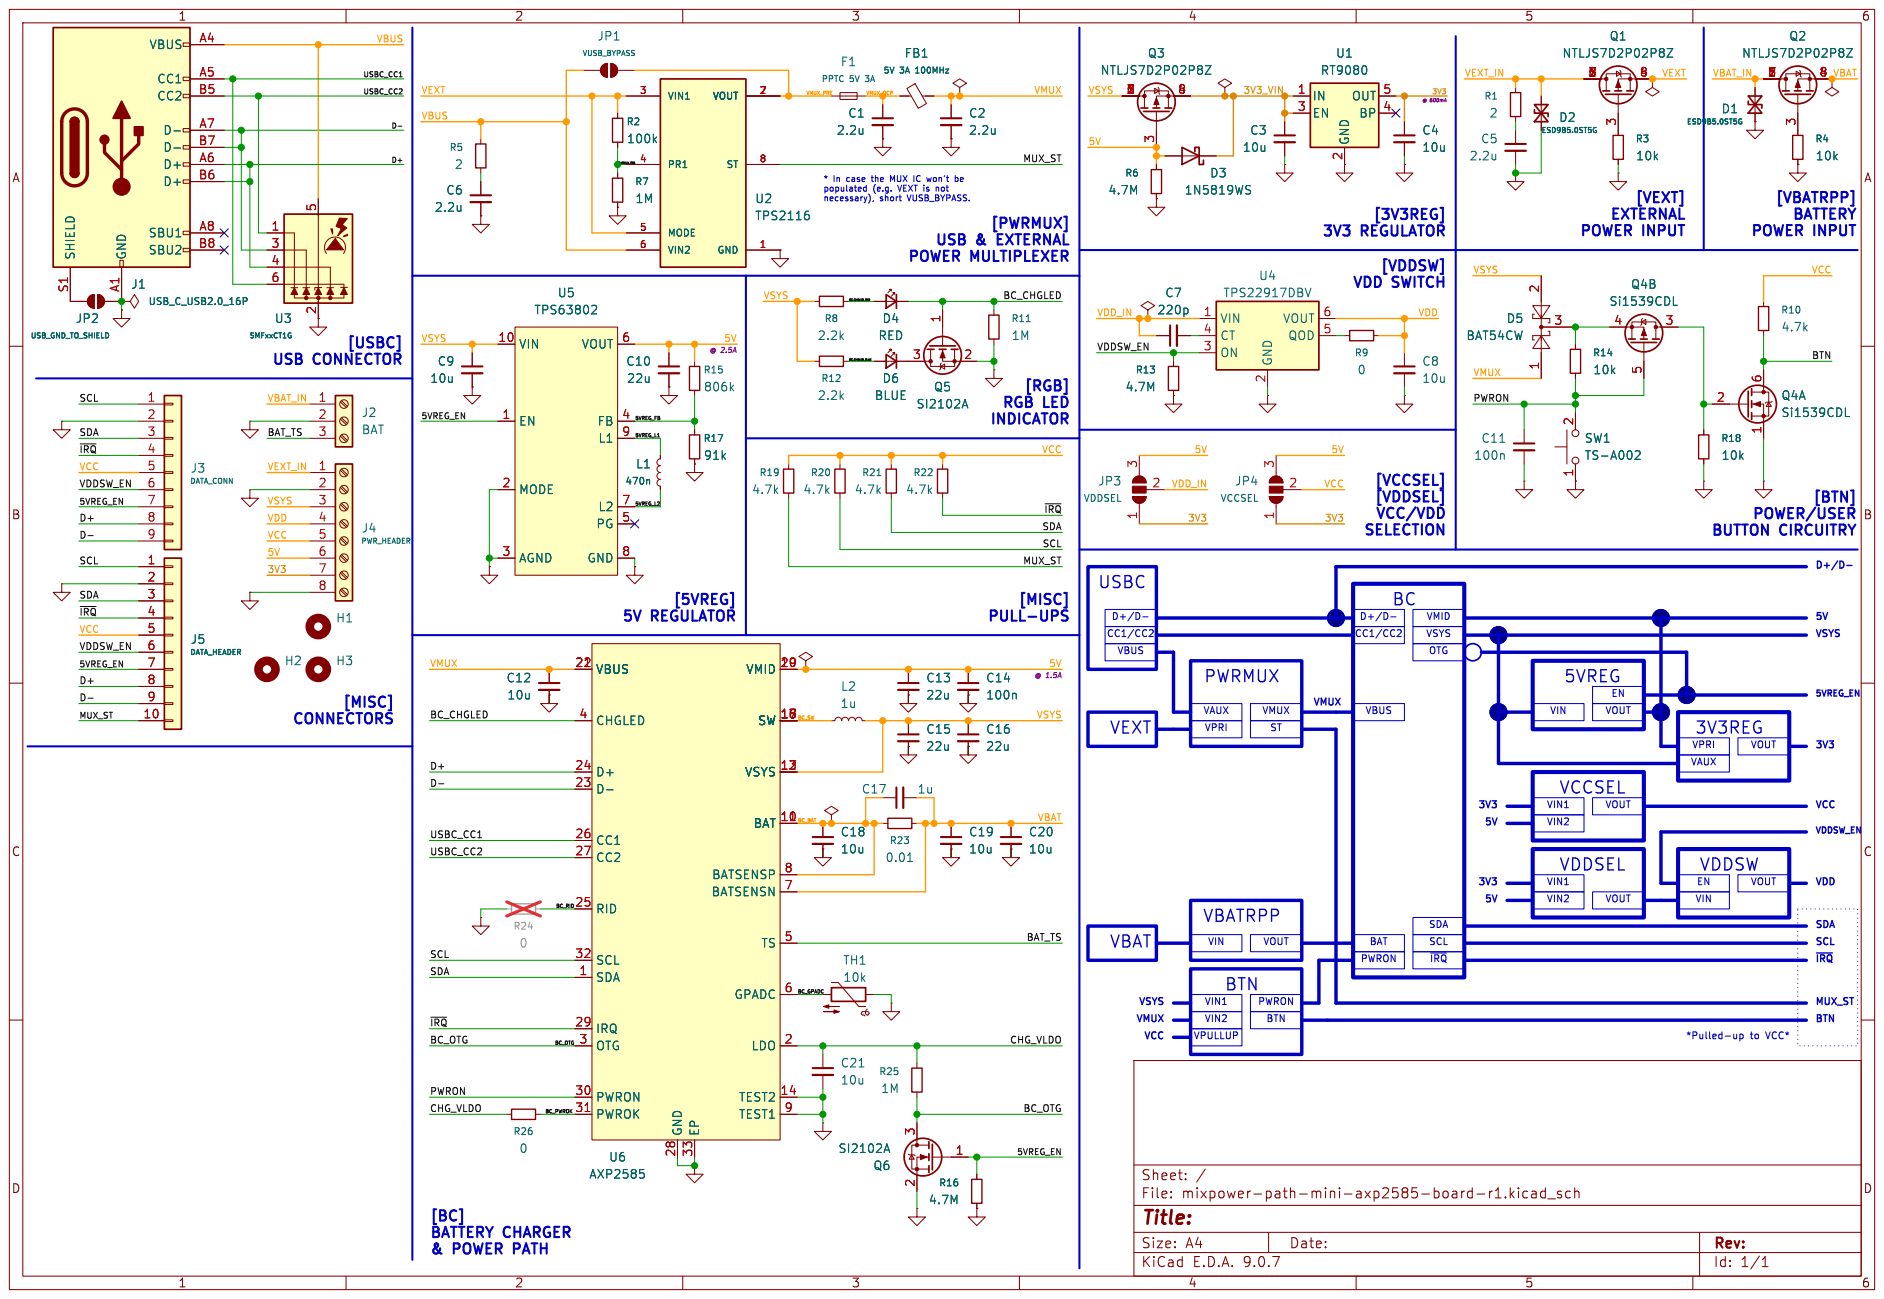
[picture p20: page 1]

* In case the MUX IC won't be

[VEXT] EXTERNAL POWER INPUT

USB & EXTERNAL POWER MULTIPLEXER

[5VREG] 5V REGULATOR
VBUS 212 CHGLED 4 D+ 24 D- 23 CC1 26 CC2 27 RID 25 SCL 32 SDA 1

10u U6 AXP2585 VBUS 212 CHGLED 4 D+ 24 D- 23 CC1 26 CC2 27 RID 25 SCL 32 SDA 1

Id: 1/1 Title: File: mixpower-path-mini-axp2585-board-r1.kicad_sch Sheet: /
