flisboac/mixpower-path-nano-bq25620-board/kicad/projects/mixpower-path-nano-bq25620-board-r1/mixpower-path-nano-bq25620-board-r1.kicad_pcb

## KiCad design kicad/projects/mixpower-path-nano-bq25620-board-r1/mixpower-path-nano-bq25620-board-r1.kicad_pcb (2026-04-05)

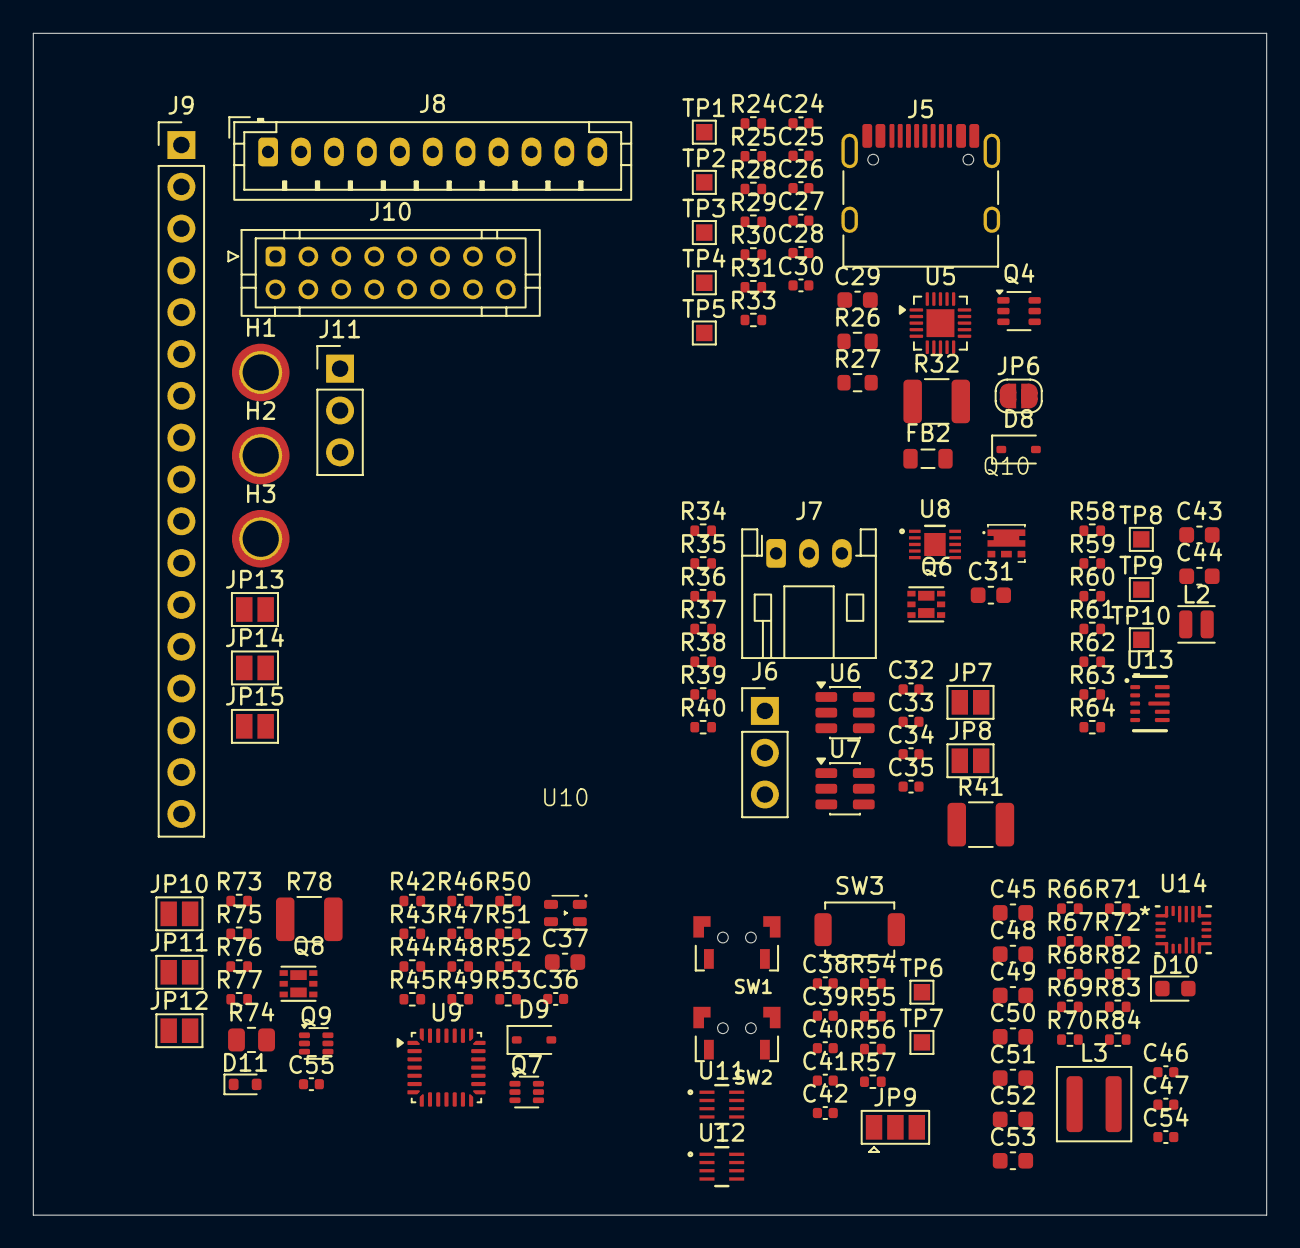
[picture p21: board mixpower-path-nano-bq25620-board-r1.kicad_pcb from above]

Board: 4 copper layers, 74.9 x 71.8 mm, 145 parts (0 on the bottom side), 93 nets.

Parts:
C24, C35: 1u; C_0402_1005Metric
C25, C27: 2.2u; C_0402_1005Metric
C26, C32, C33, C34, C36, C38, C39, C40, C41, C47, C54, C55: 100n; C_0402_1005Metric
C28, C30: 330n; C_0402_1005Metric
C29, C37, C43, C45, C50, C51, C52, C53: 10u; C_0603_1608Metric
C31: 2.2u; C_0603_1608Metric
C42: 10u; C_0402_1005Metric
C44, C48, C49: 22u; C_0603_1608Metric
C46: 47n; C_0402_1005Metric
D8: PESD24VV1BA; D_SOD-323
D9: 1N5817WS; D_SOD-323
D10: RED; LED_0603_1608Metric
D11: BZX584C18; D_SOD-523
FB2: BLM21PG300SN1D; L_0805_2012Metric
H1, H2, H3: M1; MountingHole_2.2mm_M2_ISO7380_Pad_TopBottom
J5: USB_C_Receptacle_USB2.0_16P; USB_C_Receptacle_HRO_TYPE-C-31-M-12
J6: BAT_HEADERS; PinHeader_1x03_P2.54mm_Vertical
J7: BATT; JST_PH_S3B-PH-K_1x03_P2.00mm_Horizontal
J8: DATA_CONN; JST_PH_B11B-PH-K_1x11_P2.00mm_Vertical
J9: DATA_HEADER; PinHeader_1x17_P2.54mm_Vertical
J10: HAT; JST_PHD_B16B-PHDSS_2x08_P2.00mm_Vertical
J11: DEBUG; PinHeader_1x03_P2.54mm_Vertical
JP6: USB_GND_TO_SHIELD; SolderJumper-2_P1.3mm_Open_RoundedPad1.0x1.5mm
JP7: THRM_BYPASS; SolderJumper-2_P1.3mm_Open_Pad1.0x1.5mm
JP8: BATPROT_BYPASS; SolderJumper-2_P1.3mm_Open_Pad1.0x1.5mm
JP9: EXT_BOOT_SEL; SolderJumper-3_P1.3mm_Open_Pad1.0x1.5mm
JP10: VDD1_VOTG; SolderJumper-2_P1.3mm_Open_Pad1.0x1.5mm
JP11: VDD1_VSYS; SolderJumper-2_P1.3mm_Open_Pad1.0x1.5mm
JP12: VDD1_3V3; SolderJumper-2_P1.3mm_Open_Pad1.0x1.5mm
JP13: H1_SHIELD_TO_GND; SolderJumper-2_P1.3mm_Open_Pad1.0x1.5mm
JP14: H2_SHIELD_TO_GND; SolderJumper-2_P1.3mm_Open_Pad1.0x1.5mm
JP15: H3_SHIELD_TO_GND; SolderJumper-2_P1.3mm_Open_Pad1.0x1.5mm
L2: 470n; L_Changjiang_FTC201612S
L3: 1u; L_Coilcraft_XAL4040-XXX
Q4: Si1539CDL; SOT-363_SC-70-6
Q6: DMN3032LFDBQ; Diodes-Incorporated_U-DFN2020-6_Type-B
Q7, Q9: Si1026X; SOT-563
Q8: SIA931DJ; Diodes-Incorporated_U-DFN2020-6_Type-B
Q10: NTLJS17D0P03P8Z; vendor-onsemi-483av
R24, R25, R69: 5.1k; R_0402_1005Metric
R26, R27: 27; R_0603_1608Metric
R28, R31, R34: 2; R_0402_1005Metric
R29, R30, R33, R42, R46, R58, R59, R60, R64, R66, R67, R71, R73, R75, R77: 1M; R_0402_1005Metric
R32, R78: 1k; R_1210_3225Metric
R35, R39, R54, R55, R57: 10k; R_0402_1005Metric
R36: 100; R_0402_1005Metric
R37, R40, R53, R61, R72, R82, R83, R84: 0; R_0402_1005Metric
R38, R48, R49, R50, R56: 1k; R_0402_1005Metric
R41: 0.01; R_1210_3225Metric
R43, R44, R45, R47, R51, R52: 4.7k; R_0402_1005Metric
R62: 511k; R_0402_1005Metric
R63: 91k; R_0402_1005Metric
R68: 2.2k; R_0402_1005Metric
R70: 30k; R_0402_1005Metric
R74: 220; R_0805_2012Metric
R76: 220; R_0402_1005Metric
SW1, SW2: TS-A002
SW3: TS-1088; SW_SPST_TS-1088-xR020
TP1: D-; TestPoint_Pad_1.0x1.0mm
TP2: D+; TestPoint_Pad_1.0x1.0mm
TP3: CC1; TestPoint_Pad_1.0x1.0mm
TP4: CC2; TestPoint_Pad_1.0x1.0mm
TP5: ~{USBC_FLT}; TestPoint_Pad_1.0x1.0mm
TP6, TP7: SOC_RST_PP; TestPoint_Pad_1.0x1.0mm
TP8: 3V3_EN; TestPoint_Pad_1.0x1.0mm
TP9: 3V3_MODE; TestPoint_Pad_1.0x1.0mm
TP10: 3V3_PG; TestPoint_Pad_1.0x1.0mm
U5: TPD8S300A; vendor-ti-RUK0020B
U6: TS5A3157; SOT-23-6
U7: FS312F-G; SOT-23-6
U8: MAX17055ETB; SPECIFIC_MAX17055ETB_21-100013A_T102A2&plus_1C_MXM
U9: STM32G071G8U6N; QFN-28_4x4mm_P0.5mm
U10: TJ-S1615CY6TGLCCYRGY-A5; LED-3_RGB-0603_1615Metric
U11, U12: RT9829GQW; Specific_DFN8_RT9829_RIT
U13: TPS63802; vendor-ti-DLA0010A
U14: BQ25620; vendor-ti-RYK0018A

Connections:
/input-vbat/BPROT_CS: R38.1, U7.2 (CS)
/input-vbat/BPROT_OC: Q6.5 (G2), U7.3 (OC)
/input-vbat/BPROT_OD: Q6.2 (G1), U7.1 (OD)
/input-vbat/BPROT_VCC: C33.1, R36.2, U7.5 (VCC)
/input-vbat/FG_AIN: R39.2, R40.1, U8.2 (AIN)
/input-vbat/FG_REG: C35.1, U8.7 (REG)
/input-vbat/FG_THRM: R39.1, U8.9 (THRM)
/input-vbat/FG_THRM_AIN: R40.2, U6.1
/input-vbat/THRM: JP7.2 (B), R72.2, U6.3
/input-vbat/THRM_SEL: R37.2, R71.1, U6.6, U14.3 (~PG)
/input-vbat/VBAT: C32.1, C34.1, C51.1, J9.16, Q10.4 (S), Q10.8 (S), R36.1, U8.10 (BATT), U14.8 (BAT)
/input-vbat/VBAT_GND: C34.2, C35.2, JP8.2 (B), Q6.4 (S2), R38.2, R41.1, U8.6 (CSP), U8.11 (EPAD)
/input-vbat/VBAT_GND_IN: C31.2, C33.2, J6.2, J7.2, JP8.1 (A), Q6.1 (S1), R35.2, U7.6 (GND)
/input-vbat/VBAT_GND_MID: Q6.3 (D2), Q6.6 (D1), Q6.7 (D1), Q6.8 (D2)
/input-vbat/VBAT_IN: J6.1, J7.1, Q10.1 (D), Q10.2 (D), Q10.5 (D), Q10.6 (D), Q10.7 (D), R34.1
/input-vbat/VBAT_IN_G: C32.2, Q10.3 (G), R35.1
/input-vbat/VBAT_IN_P: C31.1, R34.2
/input-vbus/SHIELD: H1.1 (1_1), H2.1 (1_1), H3.1 (1_1), J5.SH (SHIELD), JP6.2 (B), JP13.1 (A), JP14.1 (A), JP15.1 (A)
/input-vbus/USBC_CC1: J5.A5 (CC1), R25.1, U5.4 (C_CC1), U5.7 (RPD_G1)
/input-vbus/USBC_CC2: J5.B5 (CC2), R24.1, U5.5 (C_CC2), U5.6 (RPD_G2)
/input-vbus/USBC_D+: J5.A6 (D+), J5.B6 (D+), R27.1, U5.16 (D4), U5.19 (D2)
/input-vbus/USBC_D-: J5.A7 (D-), J5.B7 (D-), R26.1, U5.17 (D3), U5.20 (D1)
/input-vbus/USBC_SBU1: J5.A8 (SBU1), U5.1 (C_SBU1)
/input-vbus/USBC_SBU2: J5.B8 (SBU2), U5.2 (C_SBU2)
/input-vbus/USBC_TPS_VCC: C24.1, Q4.3 (D2), R29.1, U5.10 (VPWR)
/input-vbus/VBUS_DISCH_EN: Q4.2 (G1), R33.1, U9.2 (PC15)
/input-vbus/VBUS_USBC_IN: D8.2 (A2), FB2.1, J5.A4 (VBUS), J5.A9 (VBUS), J5.B4 (VBUS), J5.B9 (VBUS), R28.1
/input-vbus/VBUS_USBC_IN_POST_P: C27.1, R31.2
/input-vbus/VBUS_USBC_IN_PRE_P: C25.1, R28.2
/input-vbus/VPWR_EN: Q4.5 (G2), R30.1, U9.17 (PC6)
/input-vbus/~FLT: R29.2, TP5.1 (1_1), U5.9 (~FLT), U9.1 (PC14)
/output-headers/3V3: C36.1, C37.1, C38.1, C40.1, C44.1, J8.5, J9.5, J10.16, JP12.1 (A), Q4.4 (S2), R43.1, R44.1, R45.1, R47.1, R51.1, R52.1, R54.1, R55.1, R61.2, R64.2, R71.2, SW3.1, U9.3 (VDD), U10.1 (K), U11.8 (VCC), U12.8 (VCC), U13.6 (VOUT)
/output-headers/D+: J8.8, J9.8, R27.2, R82.1, TP2.1 (1_1)
/output-headers/D-: J8.9, J9.9, R26.2, R83.1, TP1.1 (1_1)
/output-headers/DBG_SWCLK: J10.6, J11.3, R53.1, U9.21 (PA14)
/output-headers/DBG_SWDIO: J10.9, J11.1, U9.20 (PA13)
/output-headers/USER1_GP1_SCL_TX: J8.1, J9.1, J10.15, U9.26 (PB6)
/output-headers/USER1_GP2_SDA_RX: J8.3, J9.3, J10.2, U9.27 (PB7)
/output-headers/USER_BOOT: J8.10, J9.10, J10.7, JP9.2 (C)
/output-headers/VBUS: C29.1, C45.1, FB2.2, J8.11, J9.11, J9.13, J10.1, R31.1, R32.1, U14.18 (VBUS)
/output-headers/VDD1: C55.1, J9.12, Q8.3 (D2), Q8.8 (D2_EP), R78.2
/output-headers/VOTG: C52.1, C53.1, C54.1, J9.15, JP10.1 (A), U14.17 (PMID)
/output-headers/VSYS: C43.1, C48.1, C49.1, J9.14, JP11.1 (A), L3.2, R58.2, R60.2, U13.10 (VIN), U14.9 (SYS)
/output-headers/~BTN: C39.1, J8.6, J9.6, J10.14, R54.2, R84.1, SW1.2, U9.28 (PB8), U11.3 (~SR1)
/output-headers/~RST: C41.1, J8.7, J9.7, J10.3, R55.2, SW2.2, U9.5 (PF2), U11.4 (~RST1), U12.3 (~SR1)
/output-headers/~USER_IRQB: D9.2 (A), J8.4, J9.4, J10.12, R52.2, U9.7 (PA1)
/ppc-bc/BC_BTST: C46.2, U14.1 (BTST)
/ppc-bc/BC_STAT: R68.2, U14.10 (STAT)
/ppc-bc/BC_STAT_PRE: D10.1 (K), R68.1
/ppc-bc/BC_THRM: C47.1, R69.1, R70.2, R72.1, U14.6 (TS)
/ppc-bc/VREGN_LP: C50.1, D10.2 (A), R66.1, R69.2, U14.2 (REGN)
/ppc-bc/VSYS_BC_SW: C46.1, L3.1, U14.16 (SW)
/ppc-bc/~CE: R66.2, R67.2, U9.15 (PB15), U14.14 (~CE)
/soc-control/BOOT: C42.1, JP9.1 (A), R53.2, R56.2, R57.1, SW3.2
/soc-control/LED_G: R49.2, U9.11 (PA5)
/soc-control/LED_R: R50.2, U9.12 (PA6)
/soc-control/LED_Y: R48.2, U9.16 (PA8)
/soc-control/PHER1_SCL: J10.13, R47.2, U8.4 (SDA), U9.18 (PA9/PA11), U14.13 (SCL)
/soc-control/PHER1_SDA: J10.4, R45.2, U8.8 (ALRT), U9.19 (PA10/PA12), U14.12 (SDA)
/soc-control/USBC_CC1: C28.1, Q7.6 (D), TP3.1 (1_1), U5.12 (CC1), U9.22 (PD0), U9.23 (PD1)
/soc-control/USBC_CC2: C30.1, Q7.3 (D), TP4.1 (1_1), U5.11 (CC2), U9.24 (PD2), U9.25 (PD3)
/soc-control/USBC_FRSTX1: Q7.2 (G), R42.2, U9.9 (PA3)
/soc-control/USBC_FRSTX2: Q7.5 (G), R46.2, U9.10 (PA4)
/soc-control/USER_IRQB_TX: D9.1 (K), U9.6 (PA0)
/soc-control/VDD1_DISCH_EN: Q9.5 (G), R77.2, U9.13 (PA7)
/soc-control/VDD1_EN: Q9.2 (G), R73.2, U9.14 (PB0)
/soc-control/~PHER1_IRQ1: J10.8, R51.2, U8.3 (SCL), U9.8 (PA2), U14.11 (~INT)
/util-buttons/SRST_BOOT_RST2: R56.1, U12.1 (RST2)
/util-buttons/SRST_RST_RST2: TP6.1 (1_1), U11.1 (RST2)
/util-buttons/~BOOT: JP9.3 (B), TP7.1 (1_1), U12.4 (~RST1)
/vload-vdd1/VDD1_IN: JP10.2 (B), JP11.2 (B), JP12.2 (B), Q8.6 (D1), Q8.7 (D1_EP)
/vload-vdd1/VDD1_MID: D11.1 (K), Q8.1 (S1), Q8.4 (S2), R75.2
/vreg-3v3/EN: R60.1, TP8.1 (1_1), U13.1 (EN)
/vreg-3v3/MODE: R58.1, R59.2, TP9.1 (1_1), U13.2 (MODE)
/vreg-3v3/VSWN_3V3_L1: L2.1, U13.9 (L1)
/vreg-3v3/VSWN_3V3_L2: L2.2, U13.7 (L2)
/vreg-3v3/VSWREG_FB: R62.1, R63.2, U13.4 (FB)
/vreg-3v3/~3V3_PG: R64.1, TP10.1 (1_1), U13.5 (PG)
GND: C24.2, C25.2, C26.2, C27.2, C28.2, C29.2, C30.2, C36.2, C37.2, C38.2, C39.2, C40.2, C41.2, C42.2, C43.2, C44.2, C45.2, C47.2, C48.2, C49.2, C50.2, C51.2, C52.2, C53.2, C54.2, D8.1 (A1), J5.A1 (GND), J5.A12 (GND), J5.B1 (GND), J5.B12 (GND), J8.2, J9.2, J9.17, J10.5, J10.10, J10.11, J11.2, JP6.1 (A), JP13.2 (B), JP14.2 (B), JP15.2 (B), Q4.1 (S1), Q7.1 (S), Q7.4 (S), Q9.1 (S), Q9.4 (S), R24.2, R25.2, R30.2, R33.2, R37.1, R41.2, R42.1, R46.1, R57.2, R59.1, R63.1, R67.1, R70.1, R73.1, R77.1, SW1.1, SW2.1, U5.8 (GND), U5.13 (GND), U5.18 (GND), U5.21 (GND), U6.2 (GND), U8.5 (CSN), U9.4 (VSS), U11.2 (VSS), U11.5 (DSR), U11.7 (~SR0), U12.2 (VSS), U12.5 (DSR), U12.7 (~SR0), U13.3 (AGND), U13.8 (GND), U14.15 (GND)
unnamed: C55.2, R76.2
unnamed: D11.2 (A), Q8.2 (G1), Q8.5 (G2), R74.2, R75.1, R76.1
unnamed: J6.3, J7.3, JP7.1 (A), U6.4
unnamed: Q4.6 (D1), R32.2
unnamed: Q9.6 (D), R74.1
unnamed: Q9.3 (D), R78.1
unnamed: R61.1, R62.2
unnamed: C26.1, U5.3 (VBIAS)
unnamed: R49.1, U10.3 (G)
unnamed: R50.1, U10.4 (R)
unnamed: R48.1, U10.2 (Y)
unnamed: R82.2, U14.5 (D+)
unnamed: R83.2, U14.4 (D-)
unnamed: R84.2, U14.7 (~QON)
