flisboac/mixpower-path-nano-bq25620-board/kicad/projects/mixpower-path-mini-axp2585-board-r1/mixpower-path-mini-axp2585-board-r1.kicad_pcb

## KiCad design kicad/projects/mixpower-path-mini-axp2585-board-r1/mixpower-path-mini-axp2585-board-r1.kicad_pcb (2026-02-23)

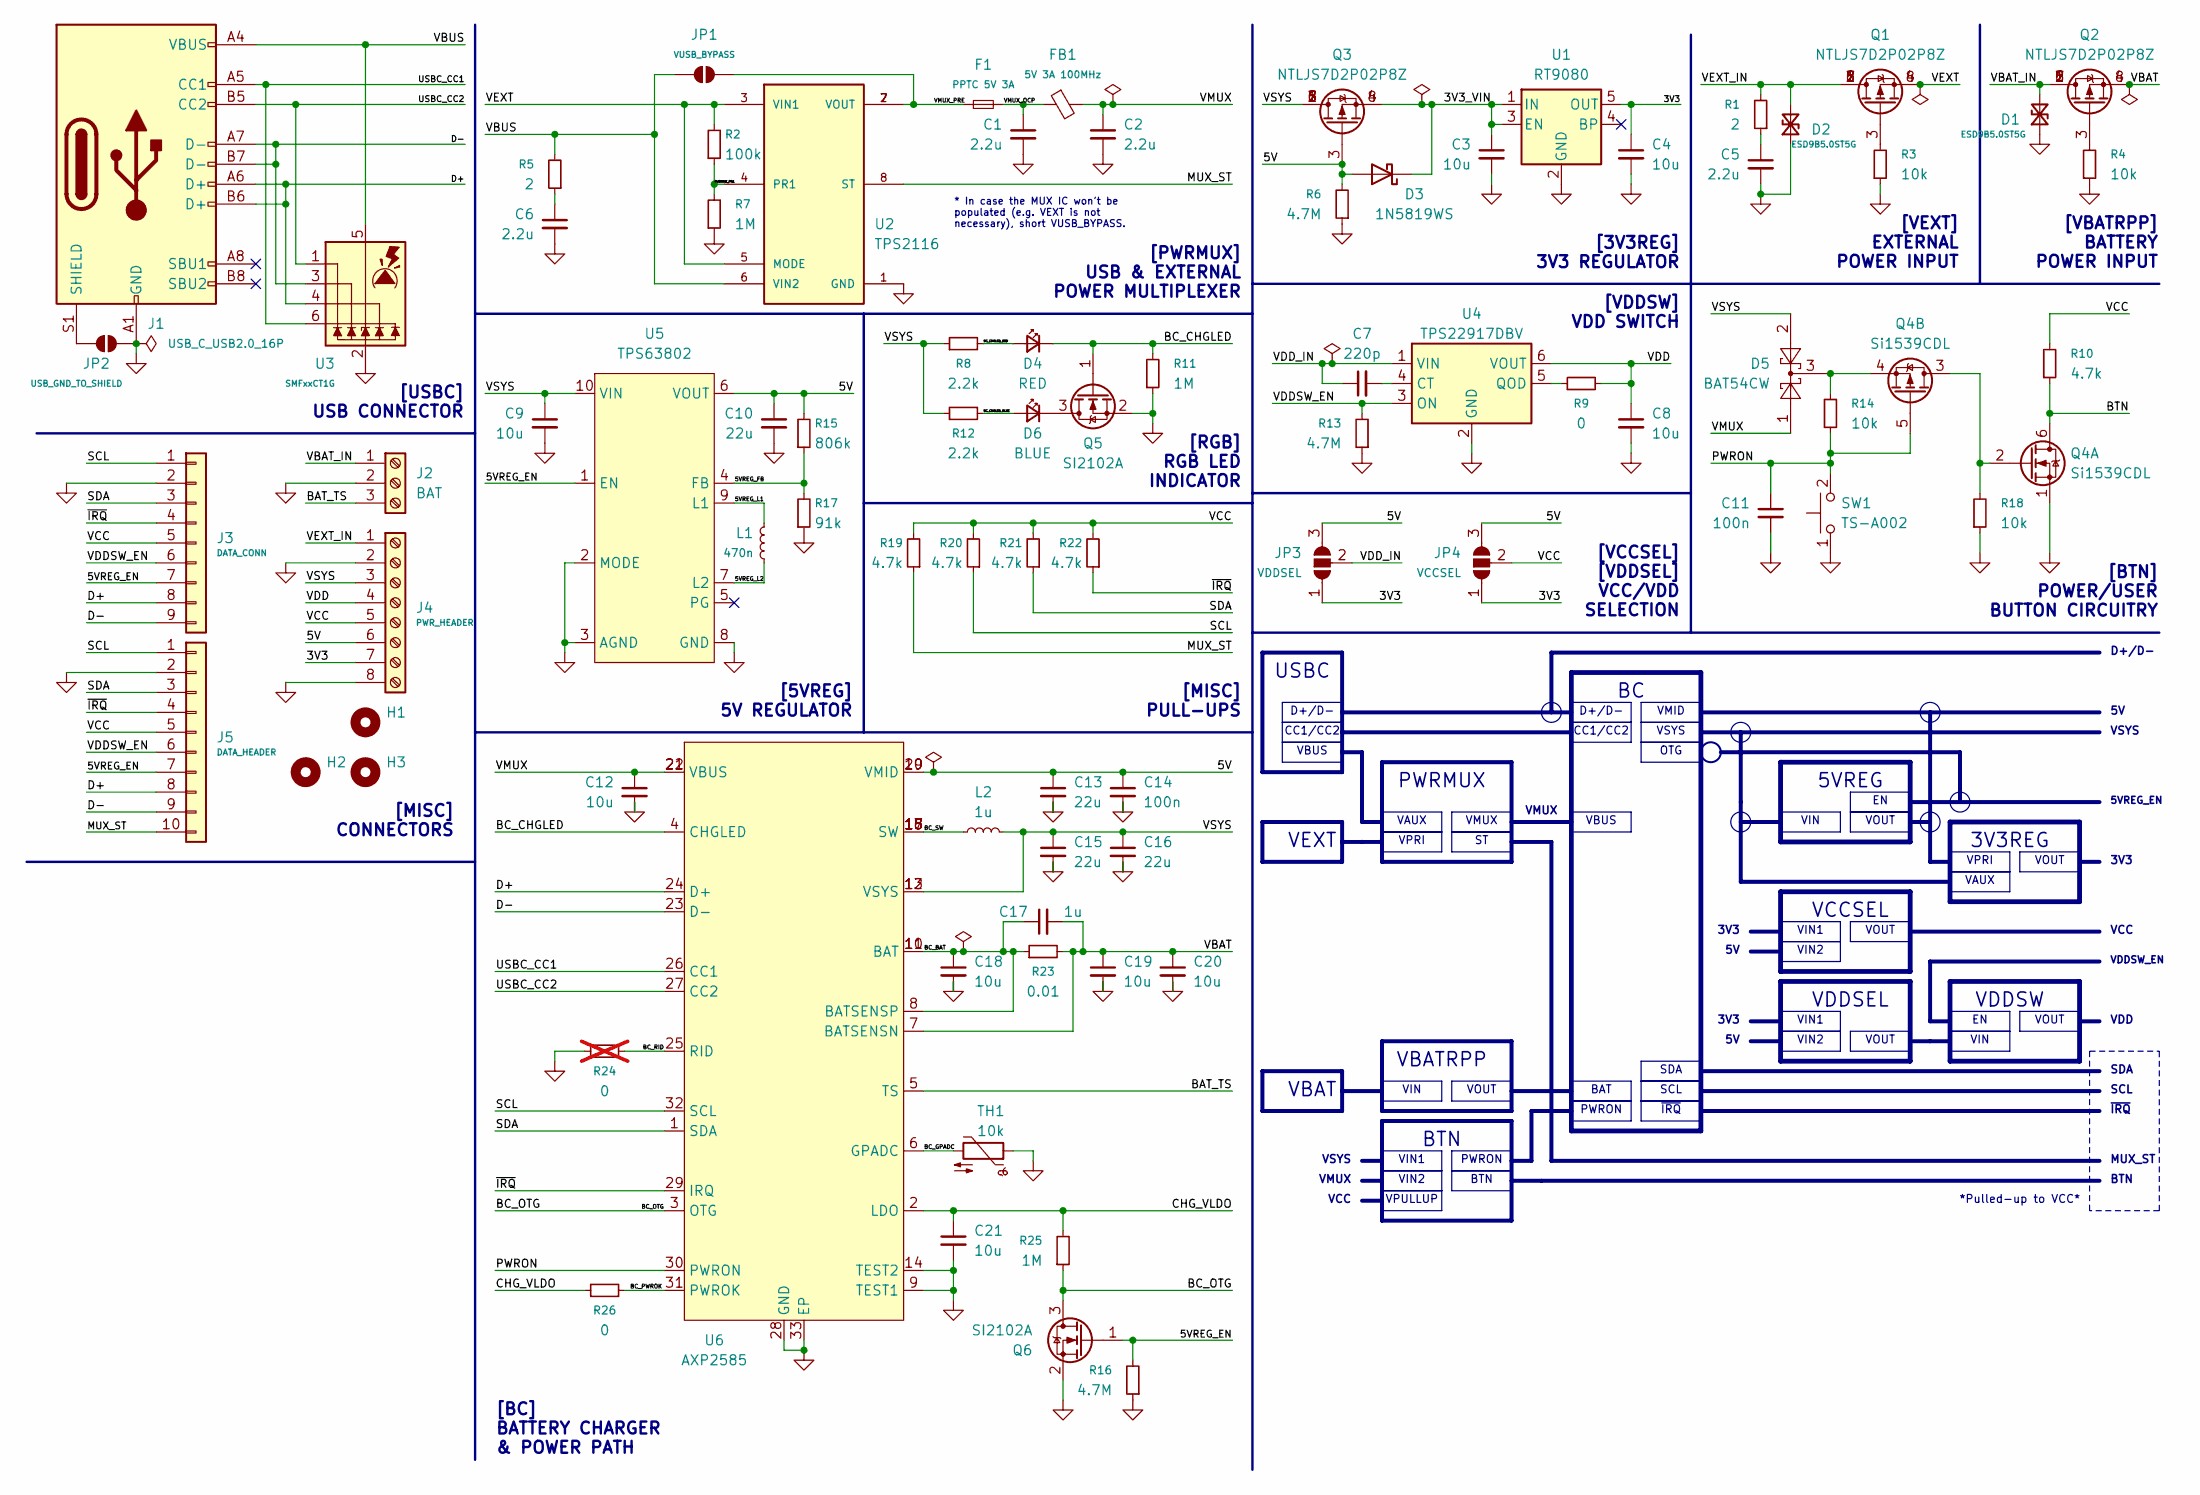
[picture p22: schematic mixpower-path-mini-axp2585-board-r1.kicad_sch]

Parts:
C1, C2, C5, C6: 2.2u; C_0402_1005Metric
C3, C4, C8, C12, C18, C19, C20, C21: 10u; C_0402_1005Metric
C7: 220p; C_0402_1005Metric
C9: 10u; C_0603_1608Metric
C10, C13, C15, C16: 22u; C_0603_1608Metric
C11, C14: 100n; C_0402_1005Metric
C17: 1u; C_0402_1005Metric
D1, D2: ESD9B5.0ST5G; D_SOD-923
D3: 1N5819WS; D_SOD-323
D4: RED; LED_0603_1608Metric
D5: BAT54CW; SOT-323_SC-70
D6: BLUE; LED_0603_1608Metric
F1: PPTC 5V 3A; Fuse_1210_3225Metric
FB1: 5V 3A 100MHz; L_1210_3225Metric
H1, H2, H3: MountingHole; MountingHole_2.2mm_M2
J1: USB_C_USB2.0_16P; USB_C_Receptacle_HRO_TYPE-C-31-M-12
J2: BAT; JST_PH_S3B-PH-K_1x03_P2.00mm_Horizontal
J3: DATA_CONN; JST_ZH_B9B-ZR_1x09_P1.50mm_Vertical
J4: PWR_HEADER; PinHeader_1x08_P2.54mm_Vertical
J5: DATA_HEADER; PinHeader_1x10_P2.54mm_Vertical
JP1: VUSB_BYPASS; SolderJumper-2_P1.3mm_Open_RoundedPad1.0x1.5mm
JP2: USB_GND_TO_SHIELD; SolderJumper-2_P1.3mm_Open_RoundedPad1.0x1.5mm
JP3: VDDSEL; SolderJumper-3_P1.3mm_Open_RoundedPad1.0x1.5mm
JP4: VCCSEL; SolderJumper-3_P1.3mm_Open_RoundedPad1.0x1.5mm
L1: 470n; L_Coilcraft_XxL4020
L2: 1u; L_Coilcraft_XAL4020-XXX
Q1, Q2, Q3: NTLJS7D2P02P8Z; vendor-onsemi-483av
Q4: Si1539CDL; SOT-363_SC-70-6
Q5, Q6: SI2102A; SOT-323_SC-70
R1, R5: 2; R_0402_1005Metric
R2: 100k; R_0402_1005Metric
R3, R4, R14, R18: 10k; R_0402_1005Metric
R6, R13, R16: 4.7M; R_0402_1005Metric
R7, R11, R25: 1M; R_0402_1005Metric
R8, R12: 2.2k; R_0402_1005Metric
R9, R26: 0; R_0402_1005Metric
R10, R19, R20, R21, R22: 4.7k; R_0402_1005Metric
R15: 806k; R_0402_1005Metric
R17: 91k; R_0402_1005Metric
R23: 0.01; R_1210_3225Metric
R24: 0; R_0402_1005Metric; not fitted
SW1: TS-A002
TH1: 10k; R_0603_1608Metric
U1: RT9080; SOT-23-5
U2: TPS2116
U3: SMFxxCT1G; SOT-363_SC-70-6
U4: TPS22917DBV; SOT-23-6
U5: TPS63802; vendor-ti-DLA0010A
U6: AXP2585; QFN-32-1EP_5x5mm_P0.4mm_EP3x3mm; LCSC C20199912

Connections:
/3V3: C4.1, J4.7, JP3.1 (A), JP4.1 (A), U1.5 (OUT)
/3V3_VIN: C3.1, D3.1 (K), Q3.4 (S), Q3.8 (S), U1.1 (IN), U1.3 (EN)
/5V: C10.1, C13.1, C14.1, D3.2 (A), J4.6, JP3.3 (B), JP4.3 (B), Q3.3 (G), R6.2, R15.2, U5.6 (VOUT), U6.19 (VMID), U6.20 (VMID)
/5VREG_EN: J2.7, J3.7, J5.7, Q6.1 (G), R16.2, U5.1 (EN)
/5VREG_FB: R15.1, R17.2, U5.4 (FB)
/5VREG_L1: L1.1, U5.9 (L1)
/5VREG_L2: L1.2, U5.7 (L2)
/BC_BAT: C17.1, C18.1, R23.1, U6.8 (BATSENSP), U6.10 (BAT), U6.11 (BAT)
/BC_CHGLED: D4.1 (K), Q5.1 (G), R11.2, U6.4 (CHGLED)
/BC_CHGLED_BLUE: D6.2 (A), R12.2
/BC_CHGLED_RED: D4.2 (A), R8.2
/BC_GPADC: TH1.2, U6.6 (GPADC)
/BC_OTG: Q6.3 (D), R25.1, U6.3 (OTG)
/BC_PWROK: R26.2, U6.31 (PWROK)
/BC_RID: R24.2, U6.25 (RID)
/BC_SW: L2.1, U6.15 (SW), U6.16 (SW), U6.17 (SW), U6.18 (SW)
/BTN: Q4.6 (D1), R10.1
/CHG_VLDO: C21.1, R25.2, R26.1, U6.2 (LDO)
/D+: J1.A6 (D+), J1.B6 (D+), J2.8, J3.8, J5.8, U3.4 (I/O3), U6.24 (D+)
/D-: J1.A7 (D-), J1.B7 (D-), J2.9, J3.9, J5.9, U3.3 (I/O2), U6.23 (D-)
/MUX_ST: J2.10, J5.10, R19.1, U2.8 (ST)
/PWRMUX_PR1: R2.1, R7.2, U2.4 (PR1)
/PWRON: C11.1, Q4.5 (G2), R14.1, SW1.2, U6.30 (PWRON)
/USBC_CC1: J1.A5 (CC1), U3.6 (I/O4), U6.26 (CC1)
/USBC_CC2: J1.B5 (CC2), U3.1 (I/O1), U6.27 (CC2)
/VBAT: C17.2, C19.1, C20.1, Q2.4 (S), Q2.8 (S), R23.2, U6.7 (BATSENSN)
/VBUS: J1.A4 (VBUS), J1.A9 (VBUS), J1.B4 (VBUS), J1.B9 (VBUS), JP1.2 (B), R5.2, U2.6 (VIN2), U3.5 (I/O5)
/VCC: J2.5, J3.5, J4.5, J5.5, JP4.2 (C), R10.2, R19.2, R20.2, R21.2, R22.2
/VDD: C8.1, J4.4, R9.2, U4.6 (VOUT)
/VDDSW_EN: J2.6, J3.6, J5.6, R13.2, U4.3 (ON)
/VDD_IN: C7.1, JP3.2 (C), U4.1 (VIN)
/VEXT: Q1.4 (S), Q1.8 (S), R2.2, U2.3 (VIN1), U2.5 (MODE)
/VEXT_IN: D2.2 (A2), J4.1, Q1.1 (D), Q1.2 (D), Q1.5 (D), Q1.6 (D), Q1.7 (D), R1.2
/VMUX: C2.1, C12.1, D5.1 (A1), FB1.2, U6.21 (VBUS), U6.22 (VBUS)
/VMUX_OCP: C1.1, F1.2, FB1.1
/VMUX_PRE: F1.1, JP1.1 (A), U2.2 (VOUT), U2.7 (VOUT)
/VSYS: C9.1, C15.1, C16.1, D5.2 (A2), J4.3, L2.2, Q3.1 (D), Q3.2 (D), Q3.5 (D), Q3.6 (D), Q3.7 (D), R8.1, R12.1, U5.10 (VIN), U6.12 (VSYS), U6.13 (VSYS)
/~IRQ: J2.4, J3.4, J5.4, R22.1, U6.29 (IRQ)
GND: C1.2, C2.2, C3.2, C4.2, C5.2, C6.2, C8.2, C9.2, C10.2, C11.2, C12.2, C13.2, C14.2, C15.2, C16.2, C18.2, C19.2, C20.2, C21.2, D1.1 (A1), D2.1 (A1), J1.A1 (GND), J1.A12 (GND), J1.B1 (GND), J1.B12 (GND), J2.2, J3.2, J4.2, J4.8, J5.2, JP2.1 (A), Q4.1 (S1), Q5.2 (S), Q6.2 (S), R3.1, R4.1, R6.1, R7.1, R11.1, R13.1, R16.1, R17.1, R18.1, R24.1, SW1.1, TH1.1, U1.2 (GND), U2.1 (GND), U3.2 (GND), U4.2 (GND), U5.2 (MODE), U5.3 (AGND), U5.8 (GND), U6.9 (TEST1), U6.14 (TEST2), U6.28 (GND), U6.33 (EP); also elsewhere on the board
unnamed: C5.1, R1.1
unnamed: C6.1, R5.1
unnamed: D5.3 (K), Q4.4 (S2), R14.2
unnamed: D6.1 (K), Q5.3 (D)
unnamed: J1.S1 (SHIELD), JP2.2 (B)
unnamed: Q1.3 (G), R3.2
unnamed: Q2.3 (G), R4.2
unnamed: Q4.2 (G1), Q4.3 (D2), R18.2
unnamed: C7.2, U4.4 (CT)
unnamed: R9.1, U4.5 (QOD)

Notes on the sheet:
3V3
VIN2
VBUS
~{IRQ}
VEXT
SDA
BTN
*Pulled-up to VCC*
VMUX
[VCCSEL] [VDDSEL] VCC/VDD SELECTION
VIN1
VOUT
VSYS
VBAT
5VREG
VAUX
[BTN] POWER/USER BUTTON CIRCUITRY
PWRMUX
VIN
SCL
CC1/CC2
VDD
PWRON
VCC
D+/D-
VDDSW_EN
* In case the MUX IC won't be populated (e.g. VEXT is not necessary), short VUSB_BYPASS.
VPRI
[VEXT] EXTERNAL POWER INPUT
[PWRMUX] USB & EXTERNAL POWER MULTIPLEXER
[USBC] USB CONNECTOR
3V3REG
VDDSW
~{IRQ}
5VREG_EN
[5VREG] 5V REGULATOR
VDDSEL
VBATRPP
USBC
MUX_ST
[VDDSW] VDD SWITCH
VMID
[BC] BATTERY CHARGER & POWER PATH
[RGB] RGB LED INDICATOR
VPULLUP
OTG
[VBATRPP] BATTERY POWER INPUT
BAT
VCCSEL
[3V3REG] 3V3 REGULATOR
[MISC] PULL-UPS
[MISC] CONNECTORS

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
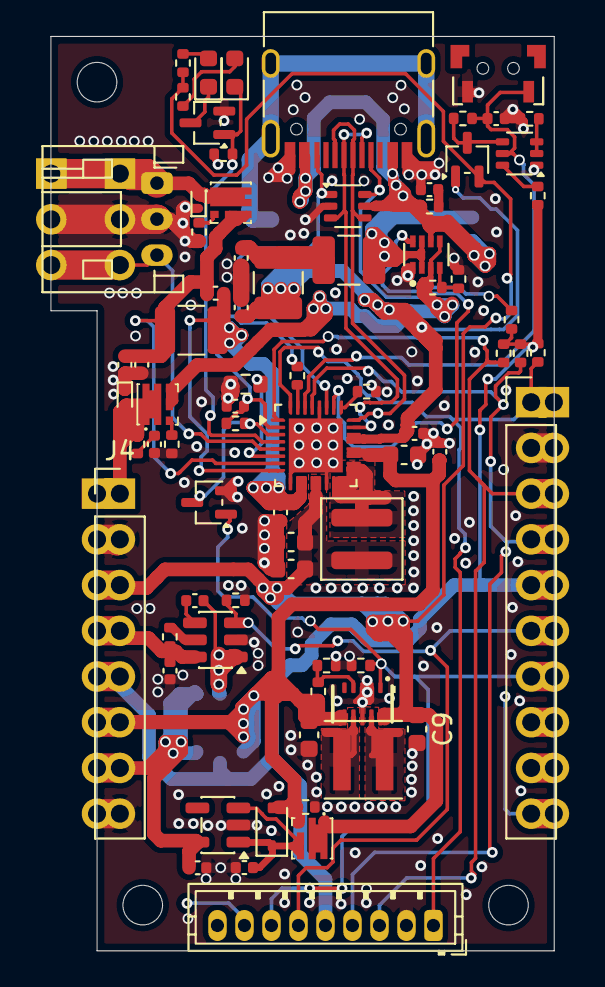
[picture p23: board mixpower-path-mini-axp2585-board-r1.kicad_pcb from above]

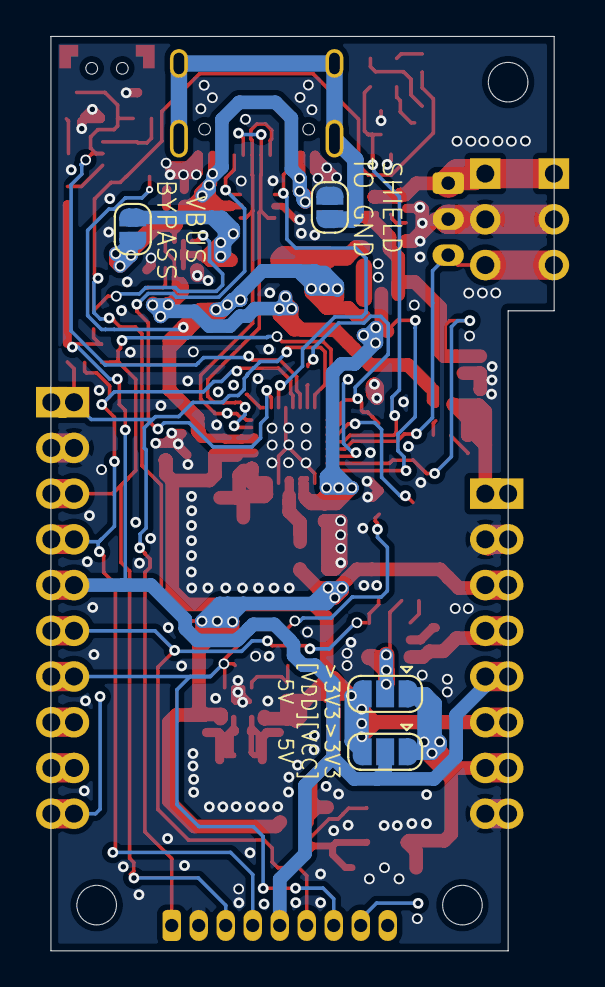
[picture p24: board mixpower-path-mini-axp2585-board-r1.kicad_pcb from below]

Board: 4 copper layers, 28.0 x 50.8 mm, 84 parts (4 on the bottom side), 53 nets.

Other parts of the board:
J2#2: BAT; JST_PH_S3B-PH-K_1x03_P2.00mm_Horizontal

Their connections:
GND: J2#2.2; also elsewhere on the board
