flisboac/mixpower-path-nano-bq25620-board/stm32cubemx/STM32G0B1CBU6/STM32G0B1CBU6.ioc

Mcu.UserName=STM32G0B1CEUx
PA0.GPIO_Label=PMIC__SWREG_MODE
PA0.Signal=GPIO_Output
PA1.GPIO_Label=USER__GP1__IRQ2__I2C1_SMBA
PA1.Signal=I2C1_SMBA
PA10.Signal=UCPD1_DBCC2
PA13.Signal=SYS_SWDIO
PA14-BOOT0.Signal=SYS_SWCLK
PA15.GPIO_Label=ADC__ENABLE_DRAIN
PA15.Signal=GPIO_Analog
PA2.Signal=ADC1_IN2
PA3.Signal=ADC1_IN3
PA4.GPIO_Label=PHER__BTN0
PA4.Signal=GPIO_Output
PA5.GPIO_Label=USBC__VCC_DIS
PA5.Signal=GPIO_Output
PA6.Signal=I2C2_SDA
PA7.Signal=I2C2_SCL
PA8.Signal=UCPD1_CC1
PA9.Signal=UCPD1_DBCC1
PB0.Signal=ADC1_IN8
PB1.Signal=ADC1_IN9
PB10.Signal=LPUART1_RX
PB11.Signal=LPUART1_TX
PB12.GPIO_Label=PHER__IRQ1__I2C2_SMBA
PB12.Signal=SharedStack_PB12
PB13.GPIO_Label=USBC__DISCH
PB13.Signal=GPIO_Input
PB14.Signal=UCPD1_FRSTX1
PB15.Signal=UCPD1_CC2
PB2.GPIO_Label=PMIC__5VREG_EN
PB2.Signal=GPIO_Output
PB3.Signal=SPI1_SCK
PB4.Signal=SPI1_MISO
PB5.Signal=SPI1_MOSI
PB6.Signal=SharedStack_PB6
PB7.Signal=SharedStack_PB7
PB8.GPIO_Label=PHER__GP3
PB8.Signal=GPIO_Analog
PB9.GPIO_Label=PHER__GP4
PB9.Signal=GPIO_Analog
PC13.GPIO_Label=PMIC__VDD1_EN
PC13.Signal=GPIO_Output
PC6.Signal=UCPD1_FRSTX2
PC7.GPIO_Label=USBC__FAULT
PC7.Signal=GPIO_Input
PD0.GPIO_Label=PHER__RGB_EN
PD0.Signal=GPIO_Output
PD1.GPIO_Label=PHER__RGB_CS
PD1.Signal=GPIO_Output
PD2.GPIO_Label=PMIC__BC_CHGEN
PD2.Signal=GPIO_Output
PD3.GPIO_Label=PHER__GP2
PD3.Signal=GPIO_Input
PF2-NRST.GPIO_Label=SOC__RESET__NRST
PF2-NRST.Signal=GPXTI2
