flisboac/mixpower-path-nano-bq25620-board/(commit log)

2026-02-16 feat: initial commit just to do a copier update
    [mixpower-path-tiny-board-r1.kicad_pcb, mixpower-path-tiny-board-r1.kicad_sch]
2026-02-23 refactor: small adjustments
    [mixpower-path-mini-axp2585-board-r1.kicad_pcb, mixpower-path-mini-axp2585-board-r1.kicad_sch, mixpower-path-tiny-axp2585-board-r1.kicad_pcb, mixpower-path-tiny-axp2585-board-r1.kicad_sch]
2026-02-23 fix: non-electrical/ small fixes to the schematic
    [mixpower-path-mini-axp2585-board-r1.kicad_sch]
2026-03-30 feat: implement the schematics and base project ideas/layout
    [bom.csv, designators.csv, input-battery.kicad_sch, input-usb.kicad_sch, input-vbat.kicad_sch, input-vbus.kicad_sch, input-vext.kicad_sch, mixpower-path-mini-bq25672-lv-board-r1.kicad_pcb]
2026-03-30 feat: add pinouts created in STM32CubeMX for the STM32G071G8U6N
2026-04-05 feat: rework schematics and add proper calculations
    [input-vbat.kicad_sch, input-vbus.kicad_sch, mixpower-path-nano-bq25620-board-r1.kicad_pcb, mixpower-path-nano-bq25620-board-r1.kicad_sch, output-headers.kicad_sch, ppc-bc.kicad_sch, soc-control.kicad_sch, util-buttons.kicad_sch]
2026-04-05 chore: regenerate schematics plots
    [mixpower-path-nano-bq25620-board-r1.kicad_pcb]
2026-04-05 fix: add project metadata and plot schematics
2026-04-05 fix: put all subsheets in root of the Kicad project, regenerate schematics plots
    [mixpower-path-nano-bq25620-board-r1.kicad_sch, subsheet__input-vbat.kicad_sch, subsheet__input-vbus.kicad_sch, subsheet__input-vext.kicad_sch, subsheet__output-headers.kicad_sch, subsheet__ppc-bc.kicad_sch, subsheet__ppc-filter.kicad_sch, subsheet__soc-control.kicad_sch]
